philnik/crane/03.crane_roller.org

#+TITLE:     crane roller
#+SETUPFILE: ./setup/setup_theme.org

* Ρουλεμαν ολίσθησης

** Δυναμη ανύψωσης

Η μεγιστη δύναμη ανύψωσης είναι:
#+tblname: Forces_at_c
| Είδος δύναμης                |  Τιμή(Ν) |
|------------------------------+----------|
| Μέγιστη δυνατότητα ανύψωσης: |    20000 |
| Συρματόσχοινο:               |      860 |
| Γαντζος                      |       70 |
|------------------------------+----------|
| Αθροισμα:                    |    20930 |
|                              | 20.930kN |
#+TBLFM: @5$2=vsum(@2..@4)

Η δύναμη θα ισομοιραστεί σε 8 ρόδες κύλισης πάνω στη δοκό.

Η δύναμη σε κάθε ρόδα είναι:
|                                   |          |   |
|-----------------------------------+----------+---|
| Δύναμη ανύψωσης :                 |    20930 | Ν |
| Δύναμη μηχανισμού ανύψωσης        |     1000 | Ν |
|-----------------------------------+----------+---|
| Άθροισμα:                         |    21930 | Ν |
| Αριθμός ροδών κύλισης             |        8 |   |
|-----------------------------------+----------+---|
| Δύναμη σε κάθε ρόδα               |  2741.25 | N |
| Εδρανα κύλισης ανά ρόδα:          |        2 |   |
| Κάθετη δύναμη στο έδρανο κύλισης* | 1370.625 | N |
#+TBLFM: @4$2=@2+@3::@6$2=@4/@5::@8$2=@6/@7

*Η δύναμη σε κάθε έδρανο κύλισης εξαρτάται και από τον τρόπο στήριξης και μπορεί να είναι διαφορετική σε κάθε έδρανο.

https://www.skf.com/in/products/rolling-bearings/ball-bearings/deep-groove-ball-bearings/productid-6000

Επιλέγονται ρουλεμαν SKF 10-6000

|                           |              |
|---------------------------+--------------|
| Bore diameter             | 10 mm        |
| Outside diameter          | 26 mm        |
| Width                     | 8 m          |
| Basic dynamic load rating | 4.75 kN      |
| Basic static load rating  | 1.96 kN      |
| Limiting speed            | 40 000 r/min |
| Reference speed           | 67 000 r/min |
| SKF performance class     | SKF Explorer |

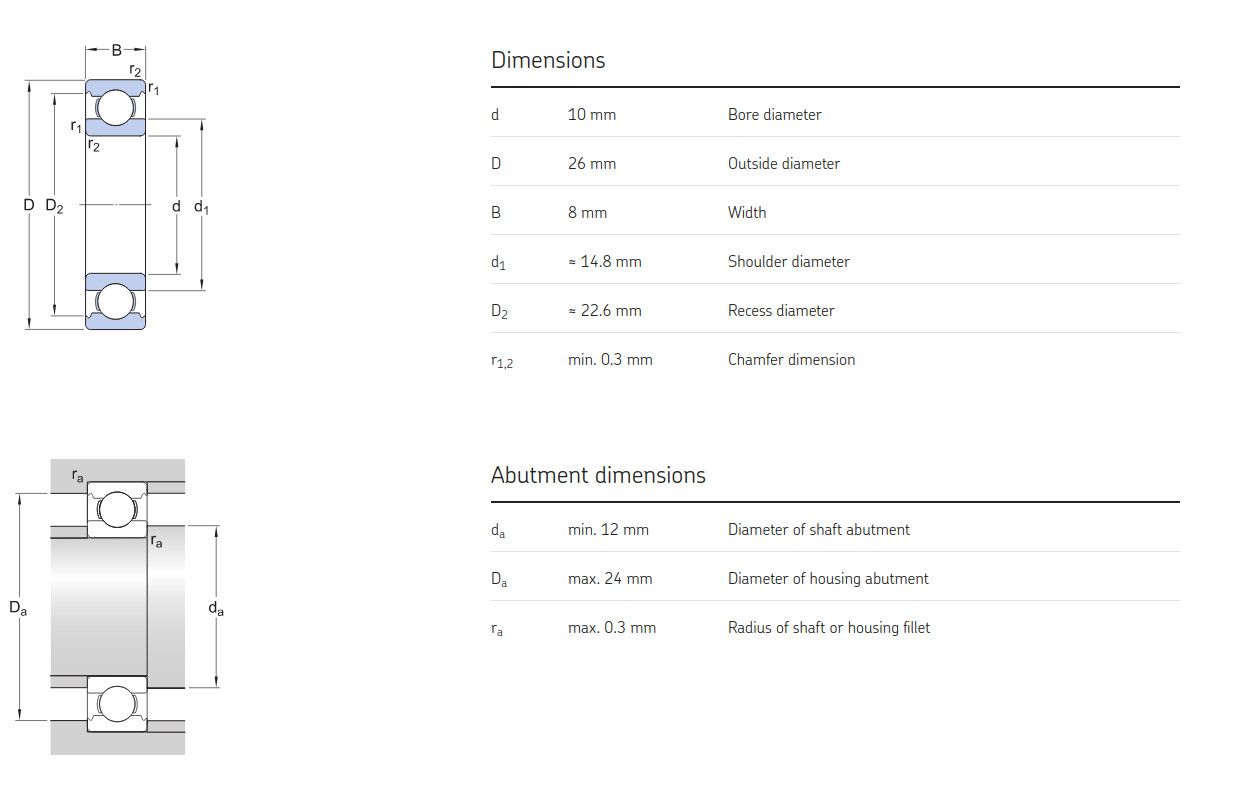
[picture p5: images/roller_bearing0.jpg]


** Ροδες κύλισης

Επιλέγονται 8 ρόδες με εξωτερική διάμετρο 34mm και πλάτος 30mm

| Εξωτερική διάμετρος | Παχος [t] | Εσωτερική διάμετρος |
| mm                  | mm        |                     |
|---------------------+-----------+---------------------|
| 34.0                | 3.2       |                27.6 |
#+TBLFM: $3=$1-2*$2

https://www.karl-georg.de/images/sortiment_laufraeder/pdf/en/crane_wheels-general_information.pdf

Τα ρουλεμαν λιπαινονται με γρασο, λογω του χαμηλού αριθμού στροφών.

** Αξονας ρουλεμαν

Ο αξονας επιλέγεται με βάση τα ρουλεμαν 10mm

** Σχέδια στηριξης

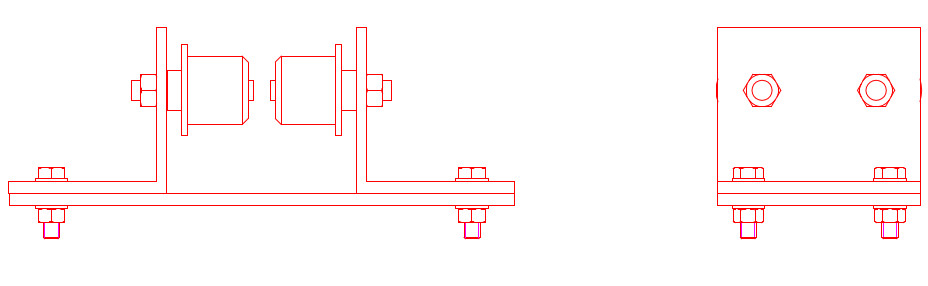
[picture p6: images/roller0.jpg]


** Σχέδια ρουλεμαν

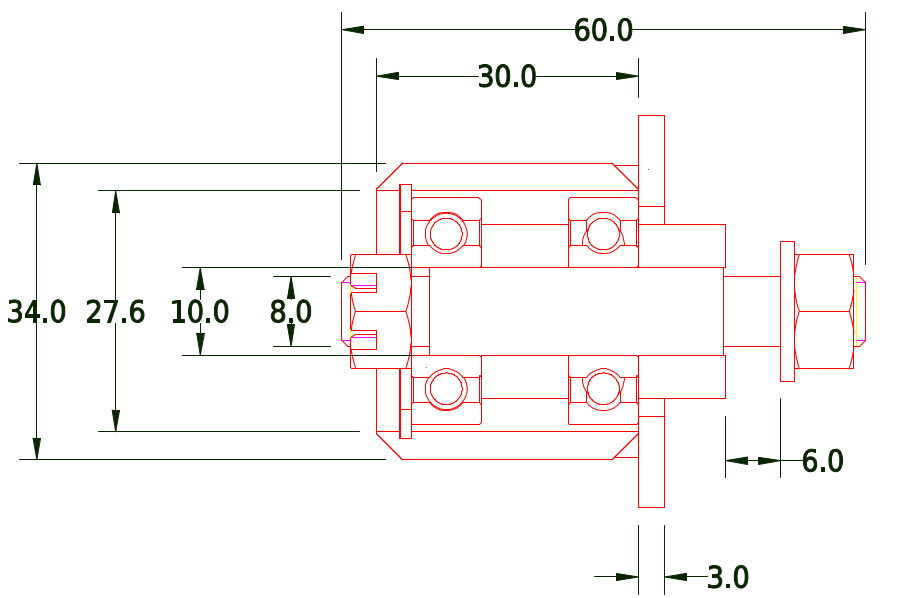
[picture p7: images/roller_detail.jpg]
