philnik/crane/02.column_ac.org

#+TITLE:     column-ac
#+SETUPFILE: ./setup/setup_theme.org

* Υπολογισμός ράβδου AC

** Δοκοί που επιλέγονται

https://eurocodeapplied.com/design/en1993/ipe-hea-heb-hem-design-properties

** Με δοκό ΗΕΑ
#+tblname: hea_beam
| Profile                                     | *HEA100* | HEA120 |
|---------------------------------------------+----------+--------|
| Depth  h  [mm]                              |       96 |    114 |
| Width  b  [mm]                              |      100 |    120 |
| Web thickness  tw  [mm]                     |        5 |      5 |
| Flange thickness  tf  [mm]                  |        8 |      8 |
| Weight  m  [kg/m]                           |     16.7 |   19.9 |
| Perimeter  P  [m]                           |    0.561 |  0.677 |
| Area  A  [mm2]                              |     2124 |   2534 |
| *Second moment of area  Iy*  [×106 mm^4]    |  *3.492* |  6.062 |
| Elastic section modulus  Wel,y  [×103 mm^3] |    72.76 |  106.3 |
| Plastic section modulus  Wpl,y  [×103 mm^3] |    83.01 |  119.5 |

** Με δοκο IPE
#+tblname: ipe_beam
| Profile                                    |  IPE80 | IPE100 | IPE120 | IPE140 | IPE160 |
|--------------------------------------------+--------+--------+--------+--------+--------|
| Depth  h  [mm]                             |     80 |    100 |    120 |    140 |    160 |
| Width  b  [mm]                             |     46 |     55 |     64 |     73 |     82 |
| Web thickness  tw  [mm]                    |    3.8 |    4.1 |    4.4 |    4.7 |      5 |
| Flange thickness  tf  [mm]                 |    5.2 |    5.7 |    6.3 |    6.9 |    7.4 |
| Root radius  r  [mm]                       |      5 |      7 |      7 |      7 |      9 |
| Weight  m  [kg/m]                          |      6 |    8.1 |   10.4 |   12.9 |   15.8 |
| Perimeter  P  [m]                          |  0.328 |    0.4 |  0.475 |  0.551 |  0.623 |
| Area  A  [mm2]                             |    764 |   1032 |   1321 |   1643 |   2009 |
| Shear area z-z  Av,z  [mm2]  (for η=1.2)   |    358 |    508 |    631 |    764 |    966 |
| Shear area y-y  Av,y  [mm2]                |    478 |    627 |    806 |   1007 |   1214 |
| Second moment of area  Iy  [×106 mm4]      | 0.8014 |   1.71 |  3.178 |  5.412 |  8.693 |
| Radius of gyration  iy  [mm]               |   32.4 |   40.7 |     49 |   57.4 |   65.8 |
| Elastic section modulus  Wel,y  [×103 mm3] |  20.03 |   34.2 |  52.96 |  77.32 |  108.7 |
| Plastic section modulus  Wpl,y  [×103 mm3] |  23.22 |  39.41 |  60.73 |  88.34 |  123.9 |

** Υπολογισμός ραβδου (AC)

Η δοκός καταπονείται (AC) σε θλίψη.

Οι εξισώσεις της αξονικής φόρτισης είναι:

$$\sigma = \frac{P}{A}$$

$$\epsilon = \frac{\sigma}{E}$$

$$\delta = \frac{P \times l}{A \times E}$$

#+tblname: area_bc
|   |                        |         |              |      |                           |
|---+------------------------+---------+--------------+------+---------------------------|
|   | Μήκος ράβδου           |         |         3000 | mm   |                           |
|   | P                      | $C_x$   |           46 | kΝ   | εφελκυσμός στη ραβδο (ΒC) |
| ^ |                        |         |            p |      |                           |
|   | Τάση διαρροής (0.2%) : | σ       |          370 | MPa  |                           |
| ^ |                        |         |            s |      |                           |
|---+------------------------+---------+--------------+------+---------------------------|
|   | Επιφάνεια δοκού        | $Α=P/σ$ | 1.2432432e-4 | m^2  |                           |
|   |                        |         |          1.2 | cm^2 |                           |
|---+------------------------+---------+--------------+------+---------------------------|
| ^ |                        |         |            A |      |                           |
|   | ενταση:                | $ε=σ/Ε$ |      1.85e-3 |      |                           |
|   | Μετατόπιση:            |         |         5.55 | mm   |                           |
#+TBLFM: @7$4=$p*1e3 / ($s*1e6)::@10$4=$s*10^6/(200*10^9)::@11$4=($p*@2)/(@7*200*10^6);%.2f

Επομένως στο όριο της δύναμης και τάση διαρροής, η ράβδος πρέπει να έχει επιφάνεια: $Α:1.24\times10^{(-4)}m^2$

** Υπολογισμός σε λυγισμό                                          :noexport:

Η ράβδος καταπονείται σε θλίψη, και εξετάζεται και ως προς την αντοχή της σε λυγισμό.

$$P_1 = K1 \frac{π^2*Ε_1*Ι_1}{l^2}$$

Από τον πίνακα 15.1 περίπτωση 1c



|   |     |             |   |    |
|---+-----+-------------+---+----|
|   | K_1 | 1.0         |   |    |
| ^ |     | k1          |   |    |
|   | E1  | 200*10^9    |   | Pa |
| ^ |     | E1          |   |    |
|   | I1  | 0.669*10^-8 |   | m4 |
| ^ |     | I1          |   |    |
|   | l   | 3           |   | m  |
| ^ |     | L           |   |    |
|---+-----+-------------+---+----|
|   |     | 1466        |   | N  |
#+TBLFM: @10$3=$k1*3.14*3.14*$E1*$I1/($L*$L);%.0f

** Απαιτούμενη αδράνεια για λυγισμό                                :noexport:



|   |                      |              |           |    |
|---+----------------------+--------------+-----------+----|
|   | K_1                  |          0.5 |           |    |
| ^ |                      |           K1 |           |    |
|   | E1                   |     200*10^9 |           | Pa |
| ^ |                      |           E1 |           |    |
|   | P                    |        46000 |           | N  |
| ^ |                      |            P |           |    |
|   | l                    |            3 |           | m  |
| ^ |                      |            L |           |    |
|---+----------------------+--------------+-----------+----|
|   | (P*l^2)/(pi^2*E1*K1) | 4.1989533e-7 | m^4       | I  |
|   |                      |    41.989533 | cm^4      |    |
|   |                      |   0.41989533 | 10^6 mm^4 |    |
#+TBLFM: @10$3=($P*$L^2)/(3.14^2*$E1*$K1)::@11$3=@-1*10^8::@12$3=@10*1e12*1e-6

Ο συντελεστής Κ1 εξαρτάται από το είδος της φόρτισης και θεωρείται  δυσμενέστερη περίπτωση $Κ1=0.507$ για ενδιάμεσο φορτίο. 

Καλπύπτουν μια από τις ακόλουθες:
- IPN80
- HEA100

** Υπολογισμός σε κάμψη

Η οριζόντια ράβδος υπολογιζεται και ως προς την αντοχή της σε κάμψη, λόγω της οριζόντιας κίνησης του κάθετου φορτίου σε ενδιάμεσες θέσεις.

Η τάση είναι:
$$\sigma = \frac{M \times c}{I}$$

Ο συντελεστής αξονικού φορτίου σε θλίψη είναι:

$$k = {\frac{P} { E \times I}}^{0.5}$$



Tο κρίσιμο σημείο αντοχής είναι κάμψη οταν η θέση του φορτίου ανύψωσης είναι στη μέση των δύο στηρίξεων (Α), (C).

Επίσης η ροπή κάμψης μειώνεται με το μήκος της ανοίγματος (AC)

Λυνουμε το σύστημα των εξισώσεων

Με δοκιμές για τις δοκούς είναι:

#+tblname: IPE_beams_calculations
|        | I [x10^6 mm^4} | Οριζόντια απόσταση l [mm] | σ [ΜPa] |   |
|--------+----------------+---------------------------+---------+---|
| IPE80  |         0.8014 |                      3000 |    3859 |   |
|        |                |                      1500 |    1589 |   |
|--------+----------------+---------------------------+---------+---|
| IPE100 |           1.71 |                      3000 |    1839 |   |
|        |                |                      1500 |     732 |   |
|--------+----------------+---------------------------+---------+---|
| IPE120 |          3.178 |                      3000 |     794 |   |
|        |                |                      1500 |     389 |   |
|--------+----------------+---------------------------+---------+---|
| IPE140 |          5.412 |                      3000 |     466 |   |
|        |                |                      2600 |     400 |   |
|        |                |                      2500 |     384 |   |
|        |                |                      2400 |     368 |   |
|        |                |                      2000 |     305 |   |
|        |                |                      1500 |     231 |   |
|        |                |                      1000 |     150 |   |
|--------+----------------+---------------------------+---------+---|

Το όριο διαρροής του σιδήρου είναι $$sigma=370MPa$$ και επιλέγεται δοκός IPE140.

To σημείο (C) μετατοπίζεται αριστερά.

*** maxima                                                         :noexport:

#+name: k_calculate
#+begin_src maxima :results output html :export result :results raw :drawer EXPORT_HTML
fpprintprec:3$

eq1: M = (W/(2*k)) * tan(k*l/2)$
disp(tex(eq1));

eq2: k=(P/(E1*I1))^0.5$
disp(tex(eq2));

eq3: M = (W/(2*k)) * tan(k*l/2);
disp(tex(eq3));

eq4: sigma = M * C / I$
print(tex(eq4));

P:46000$
E1:200*10^9$
W:27140;
M_max:M;
c:80e-3;
I:I1;
#+end_src
#+RESULTS: k_calculate
3000 2.1E+12 

      0.08 M
$$σ= ------ N/m^2$$ 
        I1

O αριθμητικός υπολογισμός δίνεται στο συνημμένο αρχείο:
[[./maxima/column_ac.mac]]

** Υπολογισμός θέσης σημείου C



Με μετακίνηση του σημείου (C) δημιουργείται ένας προβολος όταν ο γερανός μετακινείται στο πιο δεξιο σημείο.

Η ροπή είναι:

$$M=-W\times l$$

Ο πινακας υπολογισμού γίνεται:
#+tblname: IPE_beams_calculations2
|        | I [x10^6 mm^4} | Οριζόντια προβολή l2=3000-l  [mm] | σ [ΜPa] |   |
|--------+----------------+-----------------------------------+---------+---|
| IPE140 |          5.412 |                              2000 |    1400 |   |
|        |                |                              1000 |     702 |   |
|        |                |                               500 |     351 |   |
|        |                |                               400 |     280 |   |

*** maxima                                                         :noexport:

#+name: k_calculate_out
#+begin_src maxima :results output html :export result :results raw :drawer EXPORT_HTML
fpprintprec:3$
l2:1.5;
W:27140;
M:W*l2;
C:0.140;
I:5.412*10^6*10^(-12);
sigma : M * C / I$
print("l=",l2,"sigma=",sigma);
#+end_src

Επομένως επιλέγουμε οριζόντια προβολή εξωτερικά του (C) 500mm.

#+name: stability_ac
#+begin_src maxima :results output html :export result :results raw :drawer EXPORT_HTML
fpprintprec:3$

eq1: P=K1*%pi^2*E1*I1/l^2$
eq2: solve(eq1,I1);
print(tex(eq2));
print(eq2);
#+end_src

#+RESULTS: stability_ac
false 
            2
         P l
[I1 = ----------] 
         2
      %pi  E1 K1

** maxima                                                          :noexport:

programmode:false;

#+name: tension_maxima
#+begin_src maxima :results output html :export result :results raw :drawer EXPORT_HTML
fpprintprec:3$

eq1: sigma = P/A$
print(tex(eq1));

eq2: e = sigma / E$
print(tex(eq2));

eq3: delta = (P*l) / (A*E)$
print(tex(eq3))$

eq10a:solve(eq1,A)$
print(tex(eq10a));

P:54.28$
print("$$P:",P,"kN$$");

sigma:370$
print("$$σ:",370,"MPa$$");

A:(P*10^3) / (sigma*10^6) $
print("$$A:",A,"m^2$$");

E:200*10^9$
epsilon:sigma/E$
epsilon:(sigma*10^6) / E,numer$
print("$$ε:",epsilon,"$$");

l:3150$
delta: P*l / (A*E);
print("$$delta:",delta,"m$$");
#+end_src

false 
$$P: 54.2 kN$$ 
$$σ: 370 MPa$$ 
$$A: 1.46E-4 m^2$$ 
$$ε: 0.00185 $$ 
$$delta: 0.00582 m$$
