philnik/crane/04.winch.org

#+TITLE:     crane roller
#+SETUPFILE: ./setup/setup_theme.org

* Σύστημα ανύψωσης

** Δεδομένα                                                        :noexport:

Δεδομένα συστήματος:
    • L=3000 mm, R2=2800mm, R1=960mm, H=1950 mm
    • Διάμετρος τυμπάνου περιέλιξης συρματόσχοινου: 350 mm
    • Μέγιστο βάρος συρματόσχοινου: 86 Krg
    • Βάτος γάντζου ανύψωσης: 7 Krg 
    • Μέγιστη ταχύτητα ανύψωσης: 12 m/min
    • Συνολικό βάρος γερανού: 621 Kgr

Ζητούμενα:

** Υπολογισμός                                                     :noexport:

Μέρος 1 (40 Βαθμοί)
Υπολογίστε και επιλέξτε:
    • Το είδος του μειωτήρα με στόχο την επίτευξη της μέγιστης ταχύτητας ανύψωσης 
    • Τον ολικό βαθμό μείωσης
    • Τον κατάλληλο ηλεκτροκινητήρα με στόχο την ανύψωση και συγκράτηση του ανυψούμενου βάρους
    • Τις διαστάσεις του συνόλου του μειωτήρα (πχ, των χρησιμοποιούμενων γραναζιών, σφηνών, αξόνων, αποστάσεων, ανοχών, ρουλεμάν κ.α.) ώστε να εμπίπτει στις προδιαγραφές μαζί με τους απαραίτητους  υπολογιστικούς ελέγχους.
    • Δημιουργία του 3D μοντέλου του μειωτήρα μαζί με τα κατάλληλα κατασκευαστικά σχέδια τόσο των επιμέρους εξαρτημάτων όσο και του συναρμολογήματος (συμπεριλαμβάνετε η βάση και το καπάκι).

** Δύναμη ανύψωσης

Η μεγιστη δύναμη ανύψωσης είναι:
#+tblname: Forces_at_c
| Είδος δύναμης                |  Τιμή(Ν) |
|------------------------------+----------|
| Μέγιστη δυνατότητα ανύψωσης: |    20000 |
| Συρματόσχοινο:               |      860 |
| Γαντζος                      |       70 |
|------------------------------+----------|
| Αθροισμα δύναμης F:          |    20930 |
|                              | 20,93kN  |

** Υπολογισμός συστήματος ανύψωσης

** Ισχύς ανύψωσης
H απαιτούμενη ισχύς είναι:

$$W_{lift} = F \times u$$,

όπου F η δύναμη ανύψωσης $F = 21kN$
u η ταχύτητα ανύψωσης $u = 12\dfrac{m}{min}$

|                       |       |         |
|-----------------------+-------+---------|
| Δυναμη ανύψωσης [F]   |    21 | kN      |
| Ταχύτητα ανύψωσης [u] |    12 | $\dfrac{m}{min}$ |
|-----------------------+-------+---------|
| W_{lift}              | 4200. | W       |
#+TBLFM: @4$2=@2*@3*1e3/60.0

** Ροπή στρέψης τυμπάνου περιελιξης

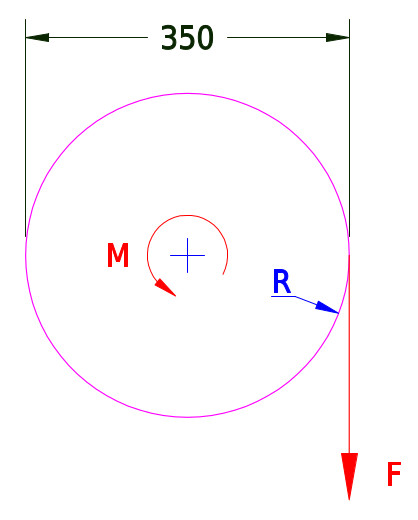
[picture p12: images/winch0.jpg]


Η ροπή στρέψης από την ανύψωση του φορτίου είναι:

$$Μ_{lift} = F \times R $$

|                     |       |    |
|---------------------+-------+----|
| Δυναμη ανύψωσης [F] |    21 | kN |
| Διάμετρος τυμπάνου  |   350 | mm |
|---------------------+-------+----|
| M_{lift}            | 3.675 | N*m |
#+TBLFM: @4$2=@2*@3*0.5*1e-3

** Στροφές τυμπάνου περιέλιξης

$$u_{lift} = \omega \times R $$

$$\omega = \frac{u_{lift}}{R} $$

|                        |     |                 |
|------------------------+-----+-----------------|
| Ταχύτητα ανύψωσης [u]  |  12 | $\frac{m}{min}$ |
| Διάμετρος τυμπάνου [D] | 350 | $mm$            |
|------------------------+-----+-----------------|
| $\omega$               |  69 | rpm             |
#+TBLFM: @4$2=60*(12/60)/(0.350/2);%.0f

** Επιλογή ανεμιστήρα

Επιλέγεται ηλεκτροκινητήρας:

|                     |     |     |
|---------------------+-----+-----|
| Ισχύς               |   4 | kW  |
| Στροφές λειτουργίας | 750 | rpm |

** Επιλογή συρματόσχοινο

Επιλέγεται συματόσχοινο με διάμετρο 6.4mm σύμφωνα με τον παρακάτω πίνακα:

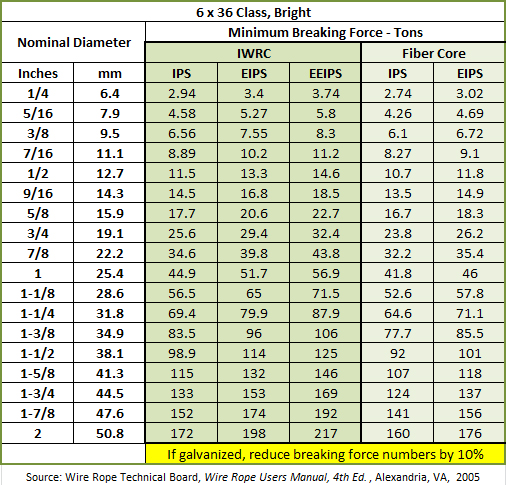
[picture p13: images/wire_rope.jpg]


Για μήκος περίπου 3m είναι:

|                                     |           |        |
|-------------------------------------+-----------+--------|
| Διάμετρος συρματόσχοινο             |       6.4 | mm     |
| Επιφάνεια                           |   32.1536 | $mm^2$ |
| Μήκος                               |      3000 | mm     |
| Όγκος                               |   96460.8 | mm^3   |
| Διάμετρος τυμπάνου                  |       350 | mm     |
#+TBLFM: @3$2=3.14*@-1*@-1/4.0::@5$2=@3*@4::@7$2=@5/@6*3.14::@9$2=1000*@7/@8

Η σχέση εξωτερικής διαμέτρου τυμπάνου και μήκους είναι:
|   | Rin | Rout |   L |
|---+-----+------+-----|
|   | 175 |  300 | 517 |
|   | 175 |  350 | 330 |

** maxima                                                          :noexport:
#+begin_src maxima
d:6.4E-3;
r:0.5*d;
area:d*d; /* area of wire rope square */
l:24;
v1: area * l;

V(Rin,Rout,L) := %pi*(Rout^2-Rin^2)*L;

#+end_src

** Διαστάσεις σωλήνα συρματοσχοινου

|  DN | NB(inch) |  ASME | SCH10 |      |
|-----+----------+-------+-------+------|
| 350 | 14"      | 355.6 |  6.35 | 7.92 |

** Αξονας στρέψης συρματόσχοινου

Η ροπή στρέψης είναι: $Τ:3675Nm$

|   |                 |          |       |   |      |
|---+-----------------+----------+-------+---+------|
| T |                 |     3675 |  3675 |   | Nm   |
| t |                 |      2.3 |   0.6 |   | mm   |
| D |                 |     21.7 |    20 |   | mm   |
| A | t*D*π           | 156.7174 | 37.68 |   | mm^2 |
|---+-----------------+----------+-------+---+------|
| τ | $\frac{T}{2tA}$ |      5.1 |  81.3 |   | MPa  |
|   |                 |          |       |   |      |
#+TBLFM: @3$4=2.3-1.7::@5$3..@5$4=@3*@4*3.14::@6$3..@6$4=(10^-6)10^(6)*@2/(2*@3*@5);%.1f

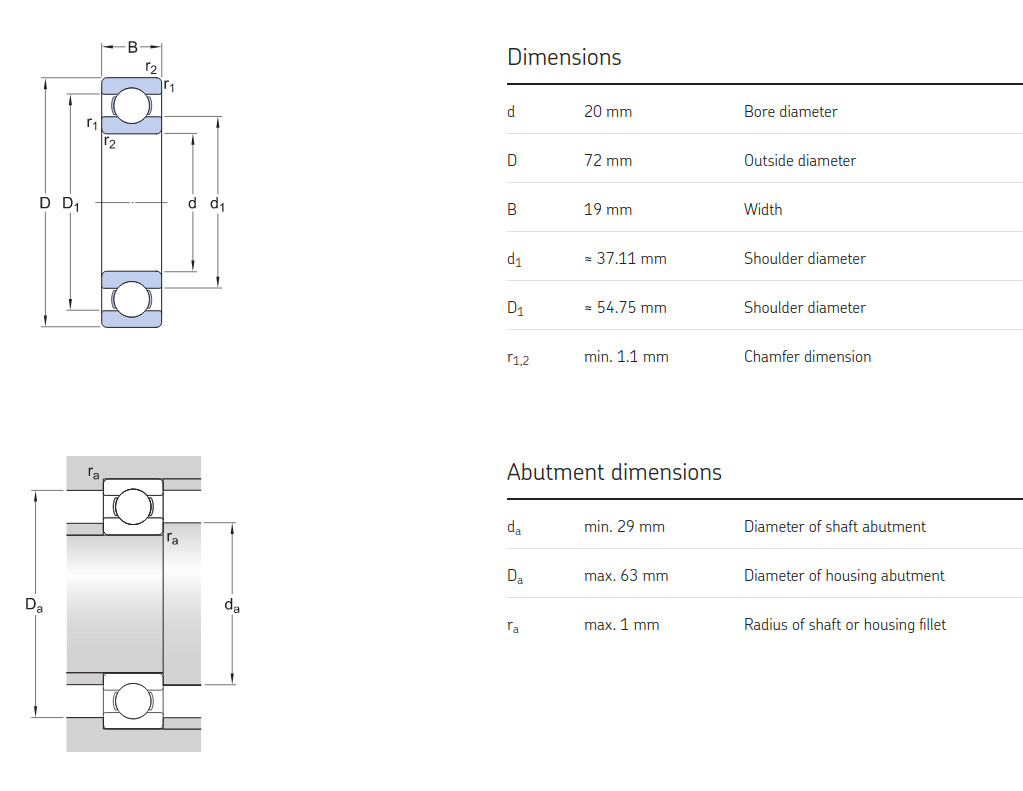
[picture p14: images/skf-20-6404.jpg]


** Ρουλεμαν

https://www.skf.com/in/products/rolling-bearings/ball-bearings/deep-groove-ball-bearings/productid-6404

Επιλέγεται τύπος ρουλεμάν: SKF-6404

Τεχνικά χαρακτηριστικά 1
|                           |         |
|---------------------------+---------|
| Basic dynamic load rating | 30.7 kN |
| Basic static load rating  | 15 kN   |
|---------------------------+---------|
| Bore diameter             | 20 mm   |
| Outside diameter          | 72 mm   |
| Width                     | 19 mm   |

Τεχνικά χαρακτηριστικά 1
| Basic dynamic load rating | C  | 30.7 kN      |
| Basic static load rating  | C0 | 15 kN        |
| Fatigue load limit        | Pu | 0.64 kN      |
| Reference speed           |    | 24 000 r/min |
| Limiting speed            |    | 15 000 r/min |
| Minimum load factor       | kr | 0.035        |
| Calculation factor        | f0 | 11           |

** Εσωτερική σωλήνα συρματοσχοινου

Πατάει στην εξωτερική του ρουλεμαν

|                 |      |
|-----------------+------|
| Diameter        | 76.3 |
| Wall thickness  |  2.8 |
| Inside diameter | 70.7 |
#+TBLFM: @3$2=@1-2*@2

** Επιλογή μειωτήρα                                                :noexport:
| Είδος                               |   Τιμή | Μονάδες |
|-------------------------------------+--------+---------|
| Στροφές ΗΚ [$i_1$]                  |    750 | rpm     |
| Στροφές τύμπάνου περιέλιξης [$i_2$] |     69 | rpm     |
|-------------------------------------+--------+---------|
| Σχέση μετάδοσης [$i]                | 10.870 |         |
| Επιλογή μειωτήρα με σχέση μετάδοσης |     12 |         |
#+TBLFM: @4$2=@2/@3;%.3f

Επιλογή module:
|                     |      |    |
|---------------------+------+----|
| module              |  2.5 |    |
| αρ.δοντιών          |  160 |    |
| εξωτερική διάμετρος | 400. | mm |
|                     |      |    |
#+TBLFM: @3$2=@1*@2

** κλπ                                                             :noexport:
| 1 |       175 |         0 |         0 |
| 2 |      87.5 |      87.5 |        1. |
| 3 | 58.333333 | 116.66667 | 2.0000001 |
| 4 |     43.75 |    131.25 |        3. |
|   |           |       175 |     175/0 |
#+TBLFM: $3=175-$-1::$4=$3/$2::@2$2=@1/$-1::@2$3=175-$2::@3$2=@1/$-1::@4$2=@1/$-1

| 1 |      87.5 |        0. |        0. |
| 2 |     43.75 |     43.75 |        1. |
| 3 | 29.166667 | 58.333333 | 2.0000000 |
| 4 |    21.875 |    65.625 |        3. |
|   |           |      87.5 |  87.5 / 0 |
#+TBLFM: $3=175*0.5-$-1::$4=$3/$2::@1$2=175/2.0::@2$2=@1/$-1::@2$3=175*0.5-$2::@3$2=@1/$-1::@4$2=@1/$-1

*** Σχεσεις μετάδοσης 

** Υπολογισμός πολυβάθμιου μειωτήρα                                :noexport:
H νεά σχέση μετάδοσης στο πολυβάθμιο μειωτήρα είναι:
| Α |  1 |
| Β |  3 |
| C |  2 |
| D |  2 |
|---+----|
|   | 12 |
#+TBLFM: @5$2=@1*@2*@3*@4

** Υπολογισμός σχέσης μετάδοσης

|   | Στροφές ΗΚ                             | $n_{motor}$                                             |  1400 | rpm   |
|---+----------------------------------------+---------------------------------------------------------+-------+-------|
|   | Μέση ταχύτητα ανύψωσης                 | $u_m$                                                   |    12 | m/min |
|   | Εσωτερική διάμετρος τυμπάνου           | $d_w = 2 \times r_w$                                    |   400 | mm    |
|   | Αριθμος συρματοσχοίνων                 | $k$                                                     |     2 |       |
|   | Περιστροφική ταχύτητα τυμπάνου         | $n_{winch} = k \times \dfrac{u_m}{r_w}$                 |   120 | rpm   |
|   | Σχέση μετάδοσης τυμπάνου               | $i_1 = \dfrac{1}{k} \times \dfrac{n_{motor}}{n_{winch}}$ | 11,66 |       |
|   | Από πίνακα σχέσης μετάδοσης επιλέγεται | $i_{total}$                                             |    12 |       |
|---+----------------------------------------+---------------------------------------------------------+-------+-------|
|   | Εσωτερική διάμετρος τυμπάνου           | $d_{in}$                                                |   350 | mm    |
|   | Εξωτερική διάμετρος τυμπάνου           | $d_{out}$                                               |   400 | rpm   |
|---+----------------------------------------+---------------------------------------------------------+-------+-------|
|   | Ταχύτητα max                           |                                                         |  8,75 |       |
|   |                                        |                                                         |       |       |
#+TBLFM: @9$4=$k*$um/($dm*0.5*1e-3);%.0f::@11$4=$nmotor/$nwinch

Η διάμετρος του τυμπάνου επηρρεάζει την ταχύτητα ανύψωσης, για σταθερές στροφές τυμπάνου.

** Πλανητικός μειωτήρας

https://en.wikipedia.org/wiki/Epicyclic_gearing

Τα στάδια του πλανητικού μειωτήρα είναι:
| Στάδια πλανητικού μειωτήρα |                    | Σχέση μετάδοσης |
|----------------------------+--------------------+-----------------|
| Στάδιο 1                   | $i_1$              |               4 |
| Στάδιο 2                   | $i_2$              |               3 |
|----------------------------+--------------------+-----------------|
|                            | $i = i_1 \times i_2$ |              12 |

** Διαστάσεις

|                     |       |   |     |    |
|---------------------+-------+---+-----+----|
| Διάμετρος δακτυλιου | $D_r$ |   | 270 | mm |
| Σχέση μετάδοσης     | $i$   |   |   3 |    |
| Διάμετρος κεντρικού | $d_r$ |   |  90 | mm |
#+TBLFM: @3$4=@1/@2
