philnik/crane/06.fem.org

#+TITLE:     winch
#+SETUPFILE: ./setup/setup_theme.org

* Ελεγχος με πεπερασμένα

** 22kN ελευθερο ακρο - Δυνάμεις



** 22kN ελευθερο ακρο - Παραμορφώσεις



*** 22kN στο μέσο - Δυνάμεις



*** Με τη διαγώνια ράβδο στήριξης 22kN στο μέσο - Παραμορφώσεις
