philnik/crane/07.drawings.org

#+TITLE:     winch
#+SETUPFILE: ./setup/setup_theme.org

* Σχέδια

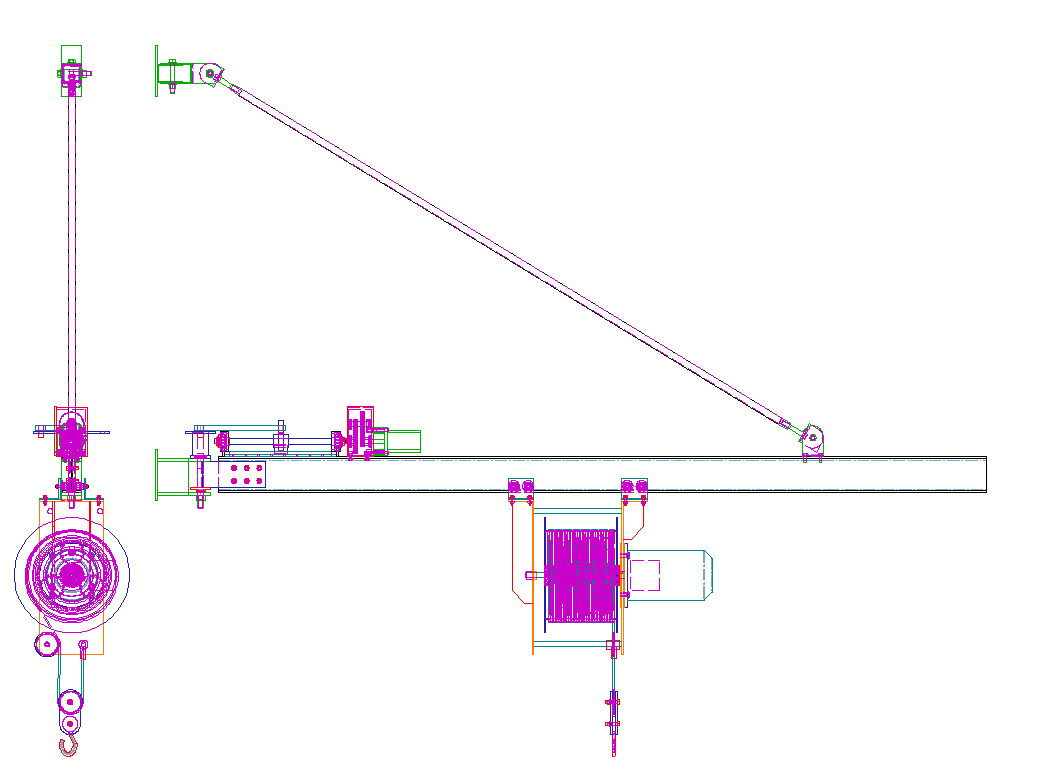
[picture p20: images/draw1.png]

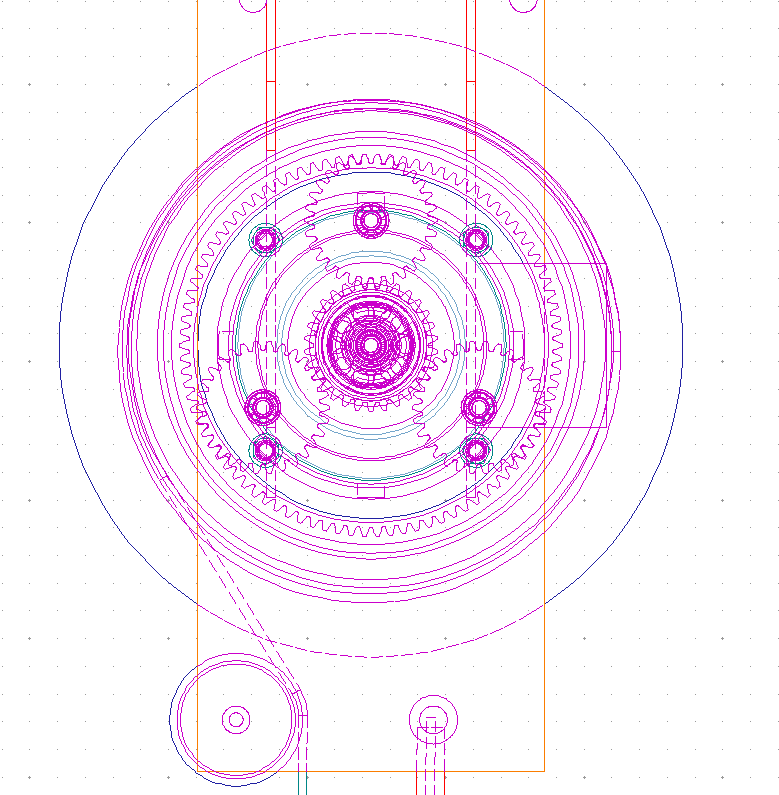
[picture p21: images/draw2.png]

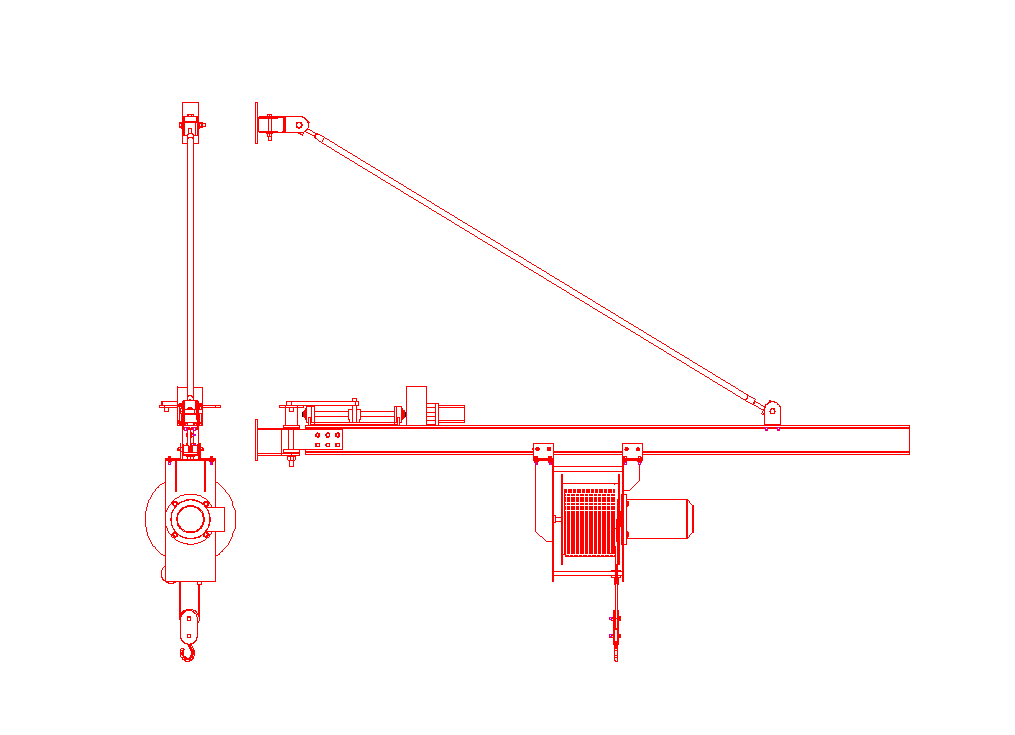
[picture p22: images/draw3.png]

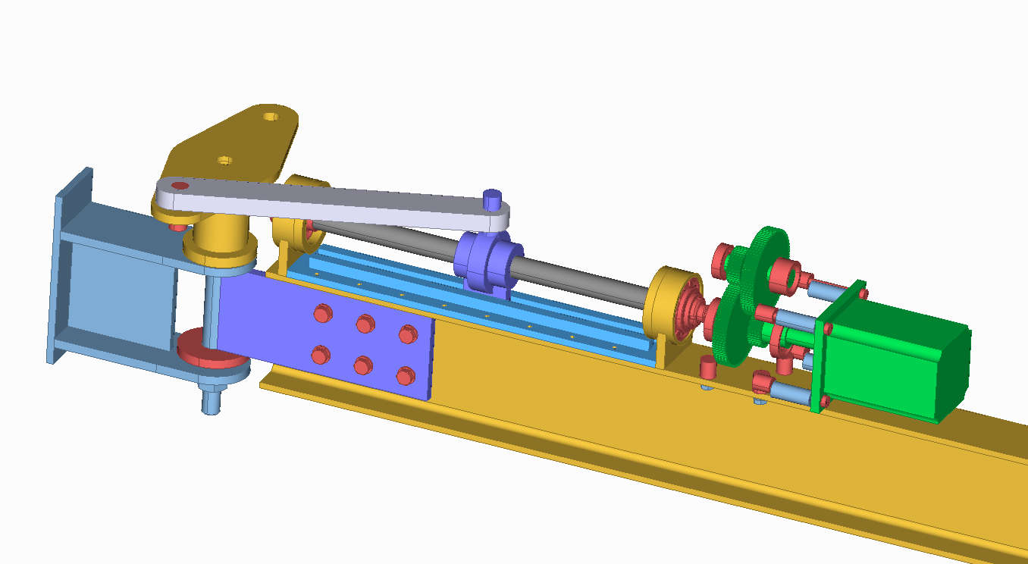
[picture p23: images/draw4.png]

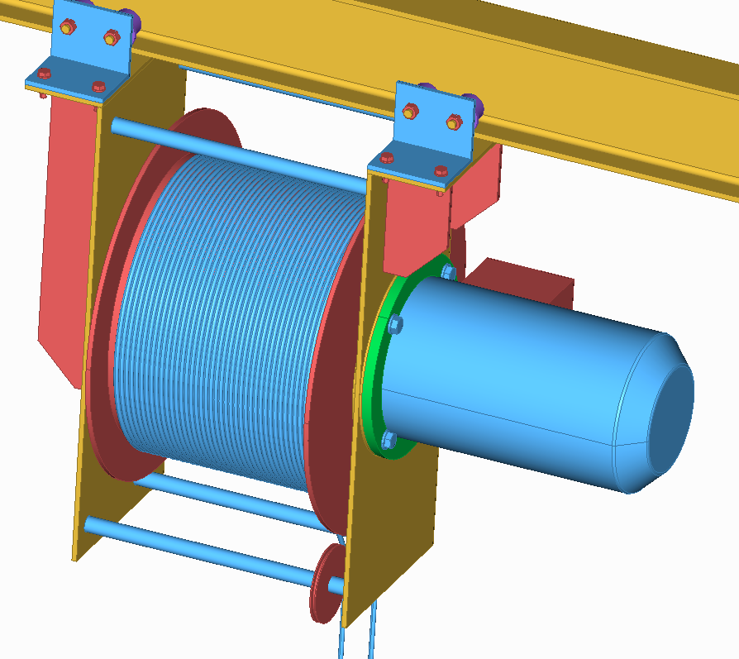
[picture p24: images/draw5.png]

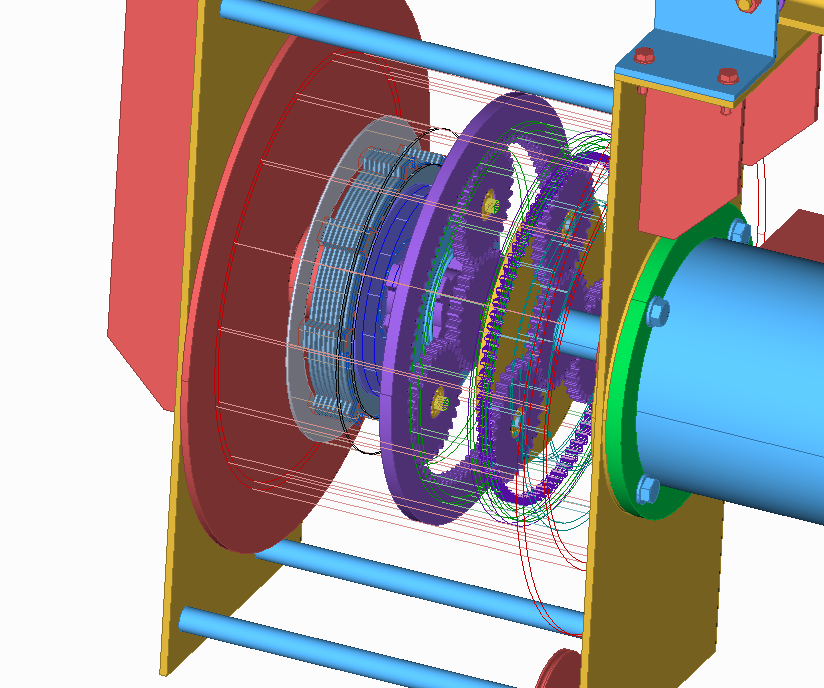
[picture p25: images/draw6.png]
