philnik/crane/pdf/crane0.pdf

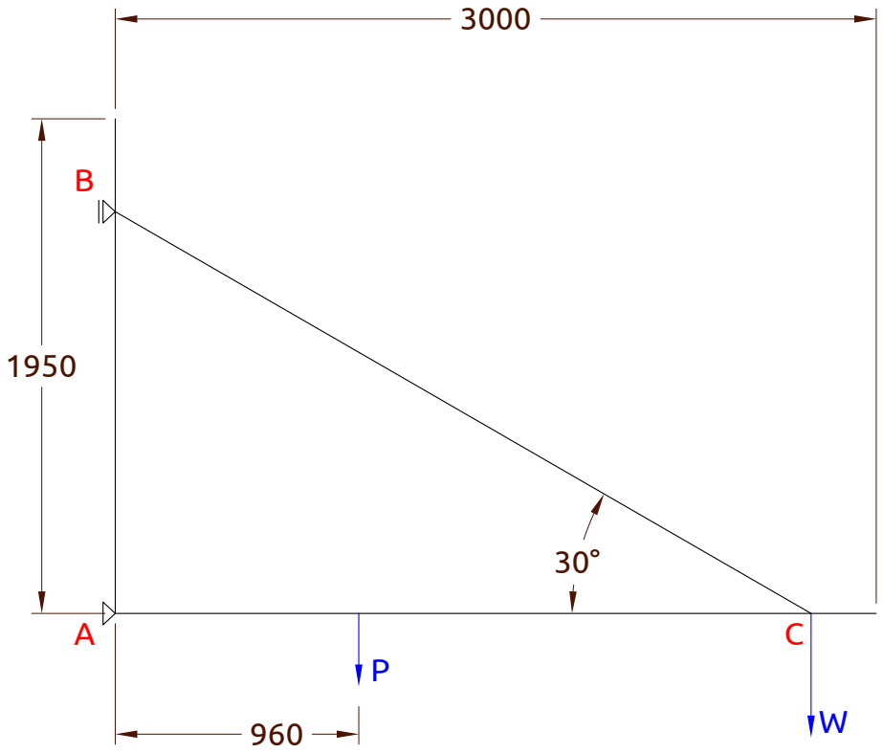
[picture p26: figure]

Cy

30°

Cx

C

Ay | C

Ax

A

A 30°

By

Bx

B

B 30°

Cy

30°

Cx

C

Ay | C

Ax

A

A 30°

By

Bx

B

B 30°
