philnik/crane/pdf/GEAR-REDUCER_Model-job_34.pdf

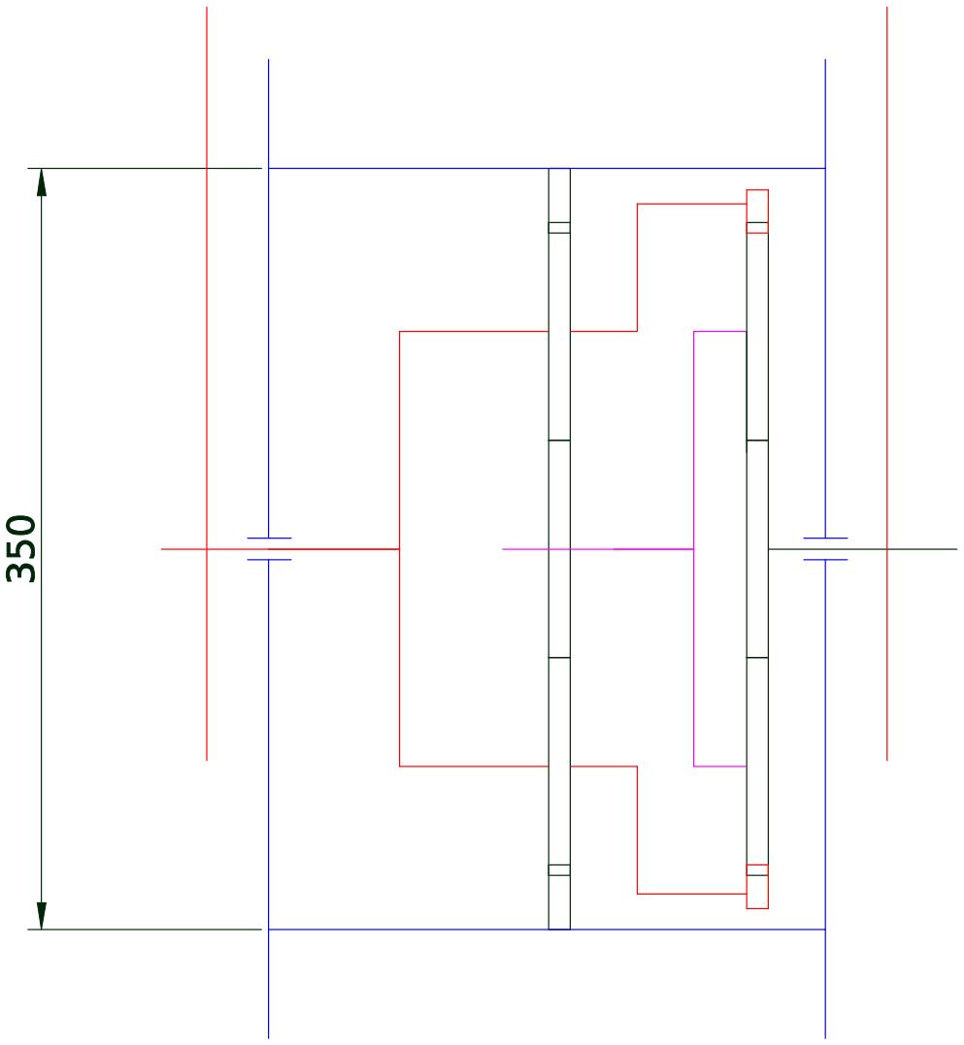
[picture p27: figure]
