philnik/crane/pdf/GEAR-REDUCER_Model-job_35.pdf

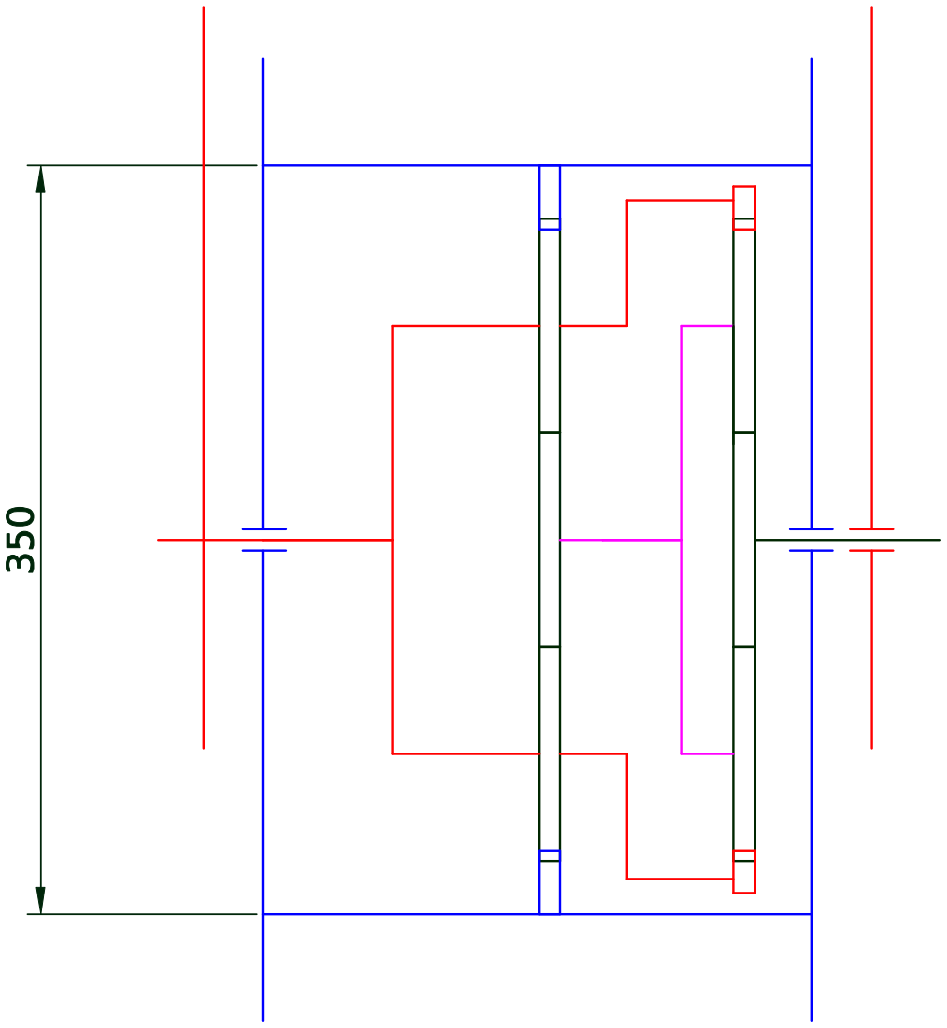
[picture p28: figure]
