philnik/crane/images/crane0.png

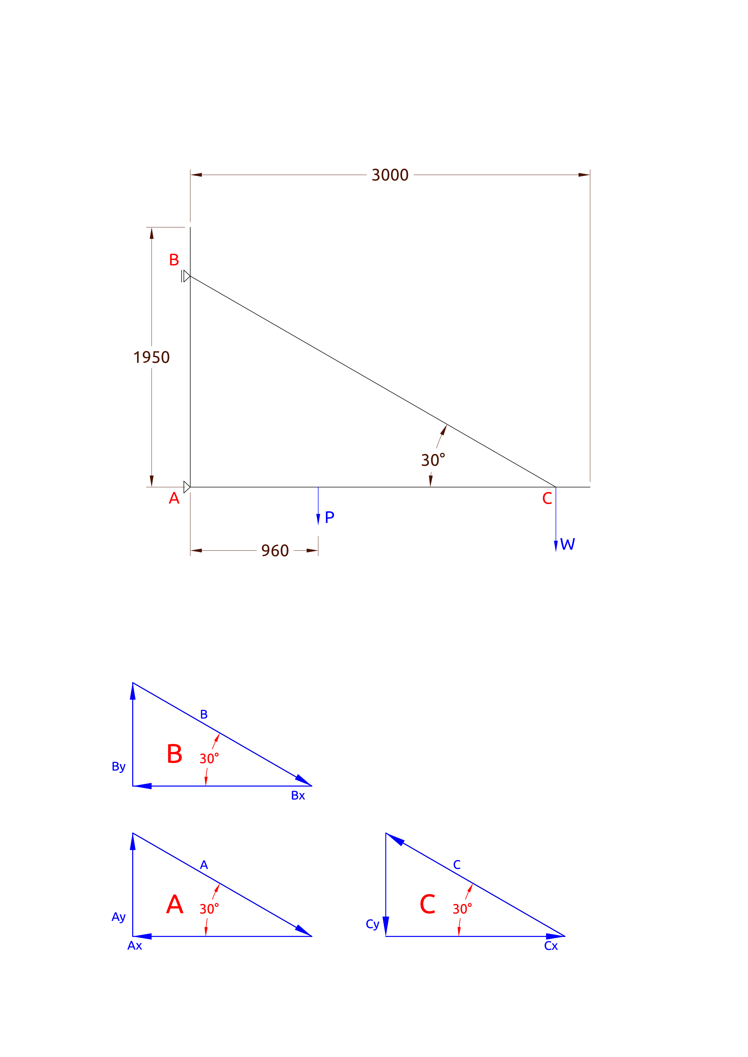
images/crane0.png
