philnik/crane/images/draw0.png

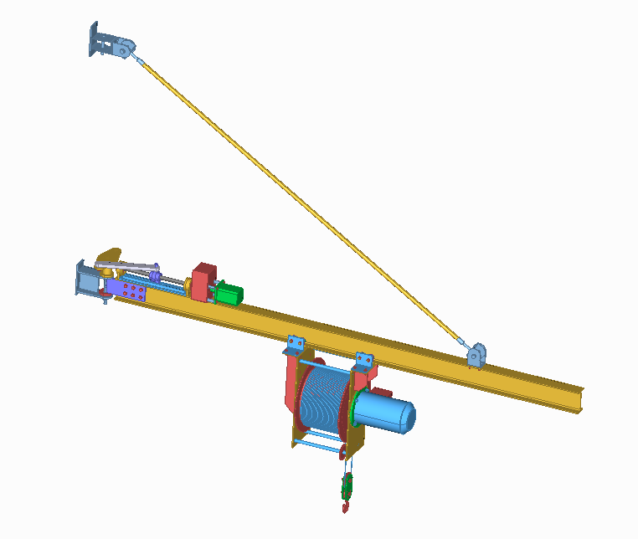
images/draw0.png
