philnik/crane/images/rotation_mechanism.png

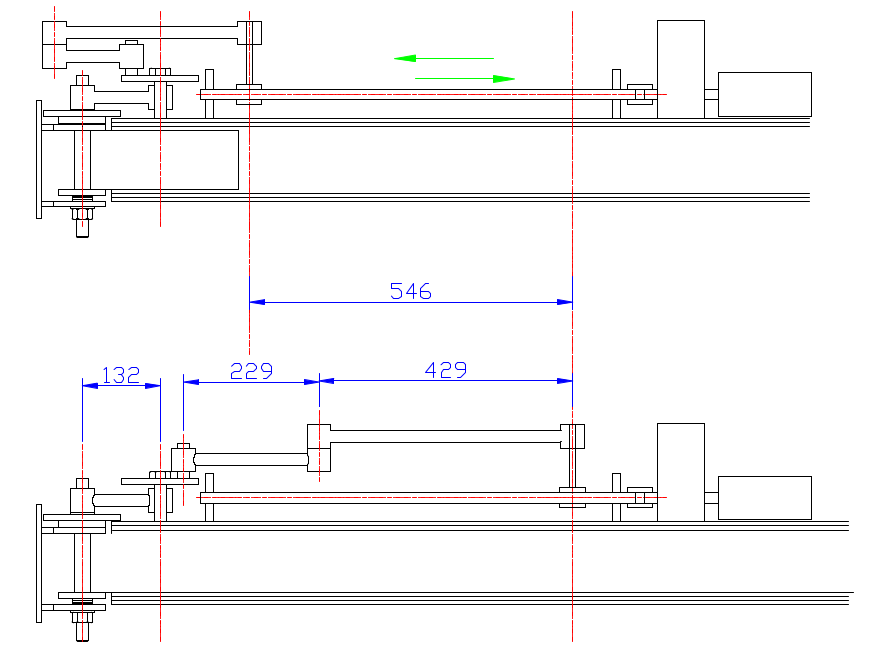
images/rotation_mechanism.png
