philnik/crane/images/x-o-roller.png

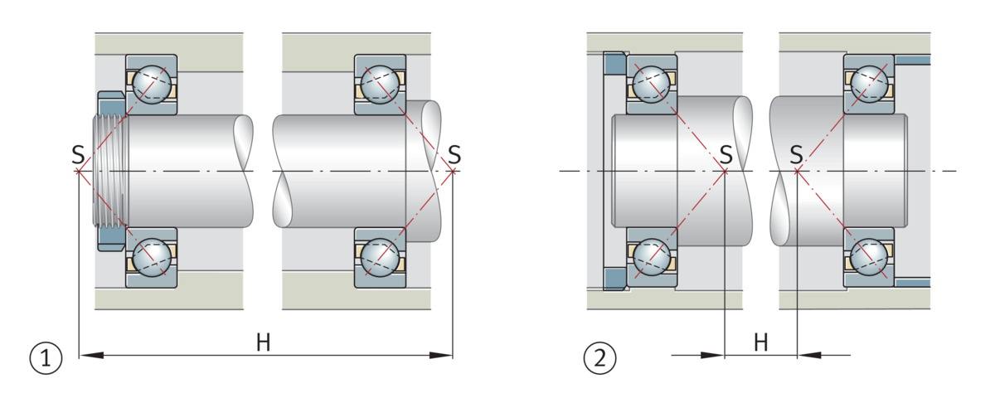
images/x-o-roller.png
