philnik/crane/cad3d/assembly.FCStd

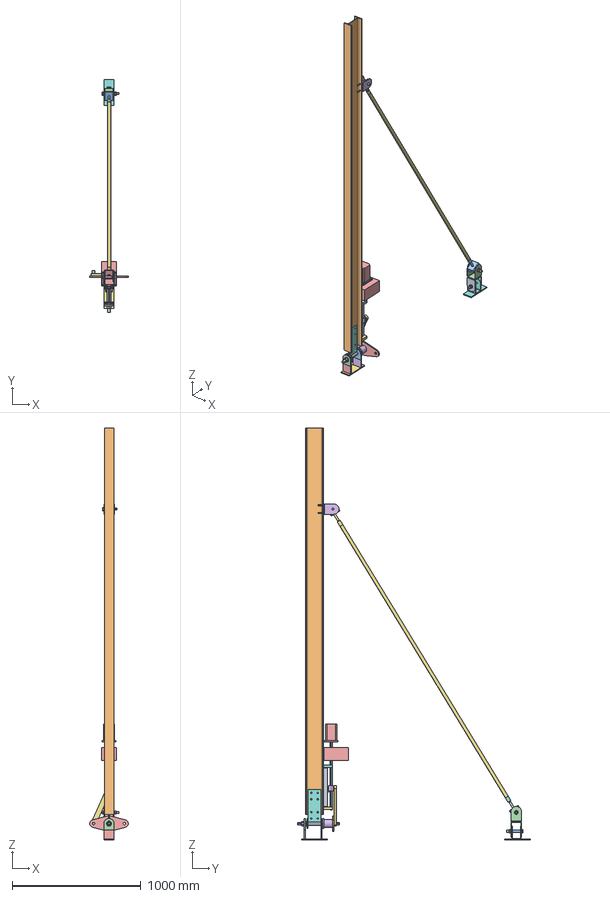
[picture p33: CAD file, 2024-03-31]
cad3d/assembly.FCStd
299.6 x 1807.5 x 3197.0 mm
