philnik/crane/cad2d/assembly.dxf

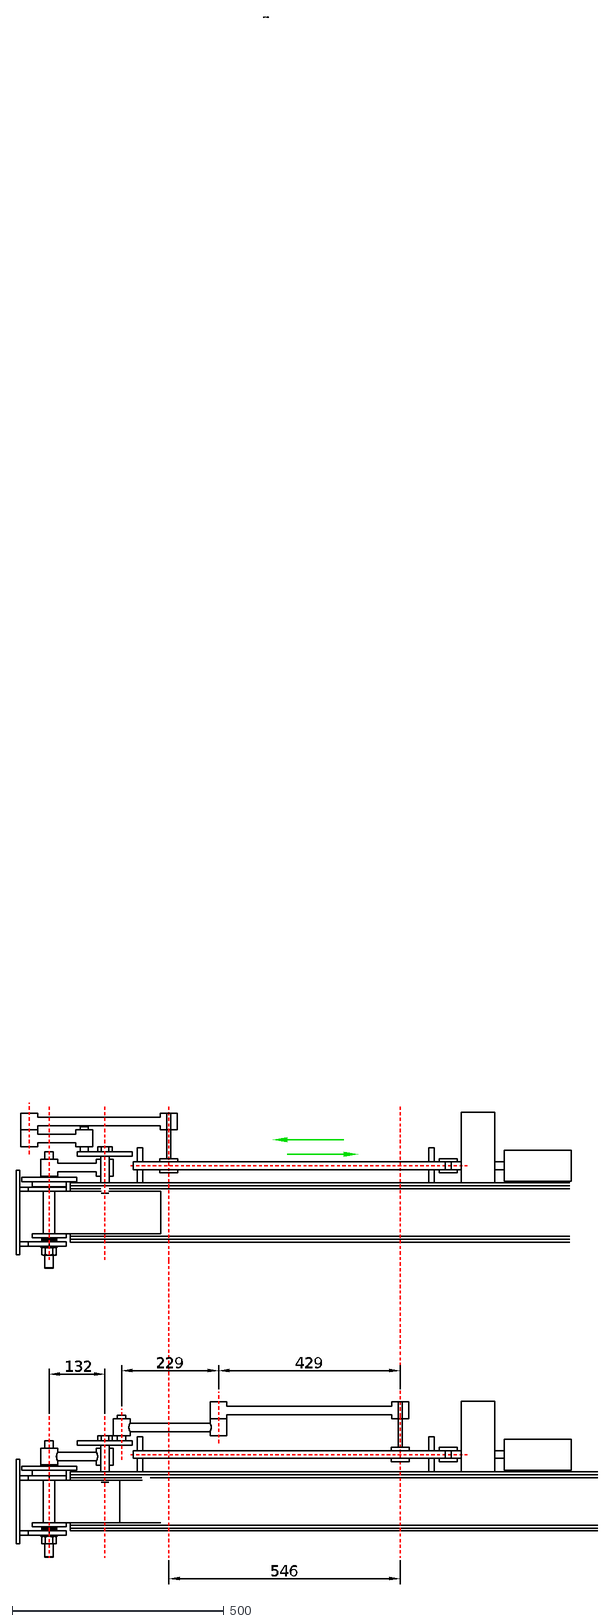
[picture p34: CAD file, 2024-03-31]
cad2d/assembly.dxf
0
546
429
229
132
