philnik/crane/cad3d/assembly1.stp

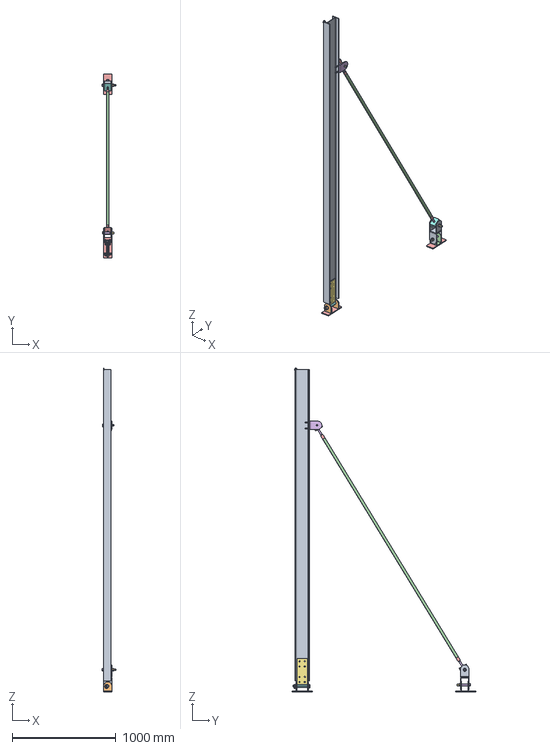
[picture p35: CAD file, 2024-03-31]
cad3d/assembly1.stp
130.0 x 1775.8 x 3120.0 mm
