philnik/crane/cad3d/nema42-stepper-motor.step

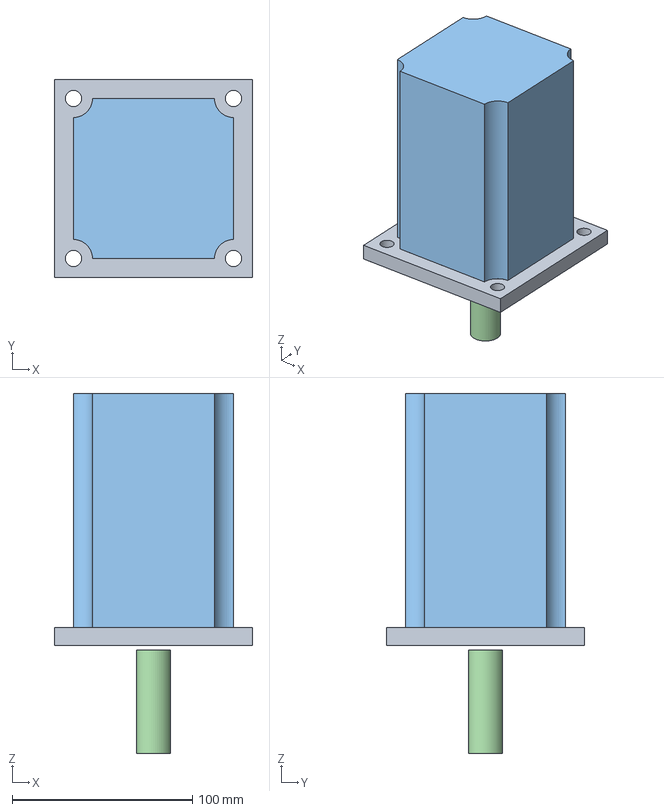
[picture p36: CAD file, 2024-03-31]
cad3d/nema42-stepper-motor.step
110.0 x 110.0 x 200.0 mm
