philnik/crane/cad2d/winch-wire.dxf

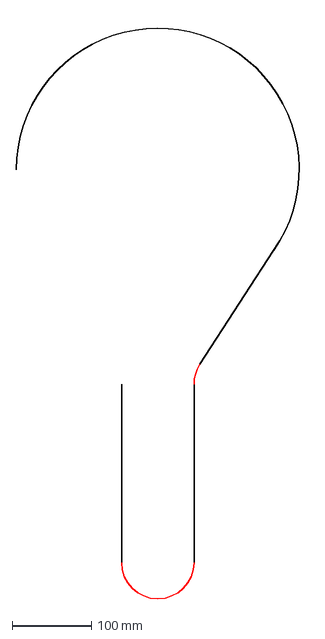
[picture p37: CAD file, 2024-03-31]
cad2d/winch-wire.dxf
367.9 x 733.6 mm
