philnik/crane/cad2d/ekkremes.dxf

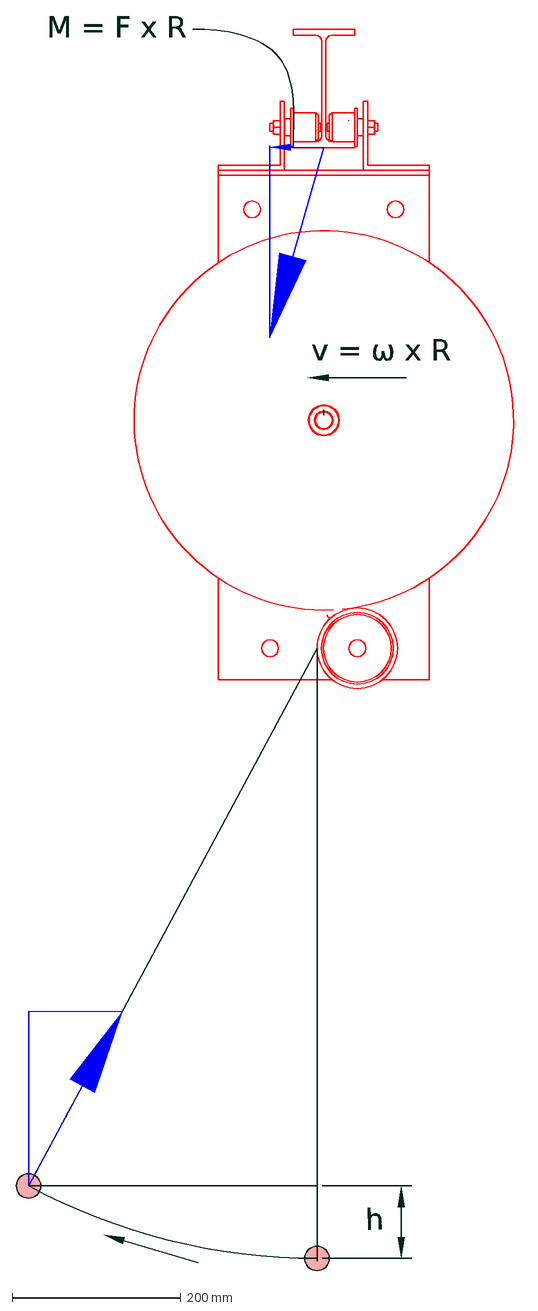
[picture p38: CAD file, 2024-03-31]
cad2d/ekkremes.dxf
v = ω x R
h
M = F x R
