philnik/crane/cad3d/rotary-piece-2.step

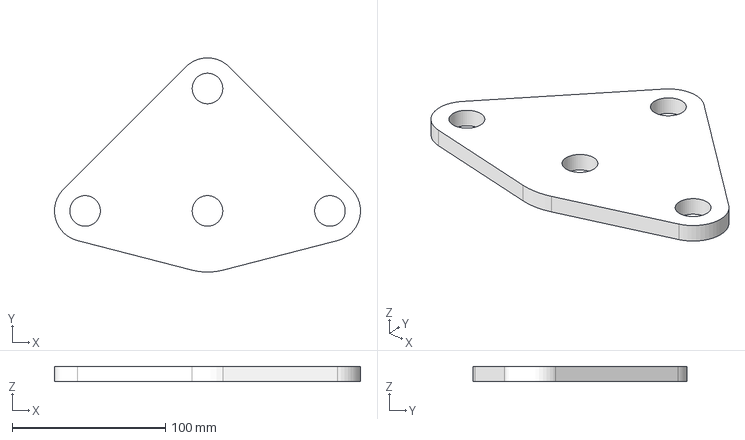
[picture p39: CAD file, 2024-03-31]
cad3d/rotary-piece-2.step
200.0 x 139.9 x 10.0 mm
