philnik/crane/cad2d/down_bracket.dxf

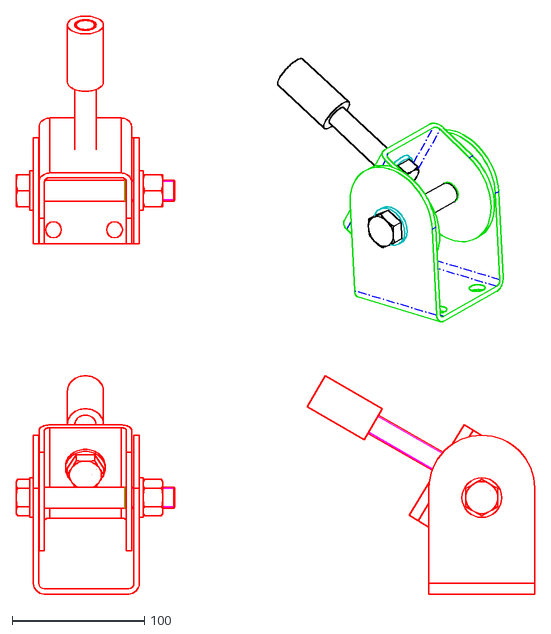
[picture p40: CAD file, 2024-03-31]
cad2d/down_bracket.dxf
392.1 x 437.2
