philnik/crane/cad3d/gearbox-small.FCStd

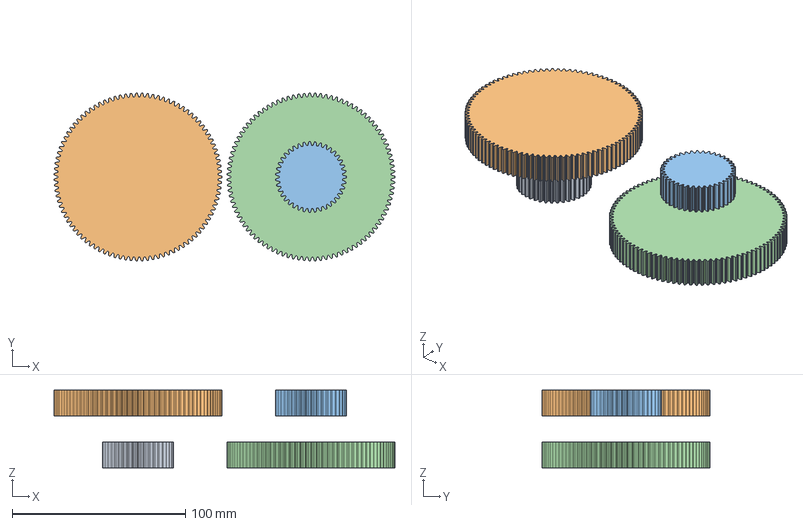
[picture p41: CAD file, 2024-03-31]
cad3d/gearbox-small.FCStd
197.0 x 97.0 x 45.0 mm
small-gear-2
