philnik/crane/cad3d/brackets.FCStd

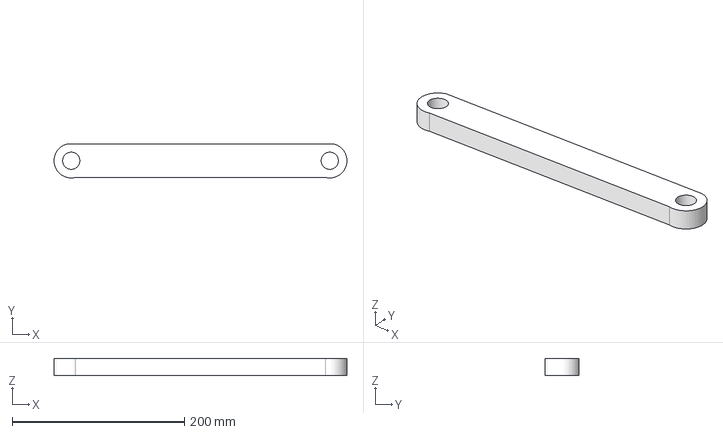
[picture p42: CAD file, 2024-03-31]
cad3d/brackets.FCStd
340.0 x 39.4 x 20.0 mm
