philnik/crane/cad3d/branch-200.step

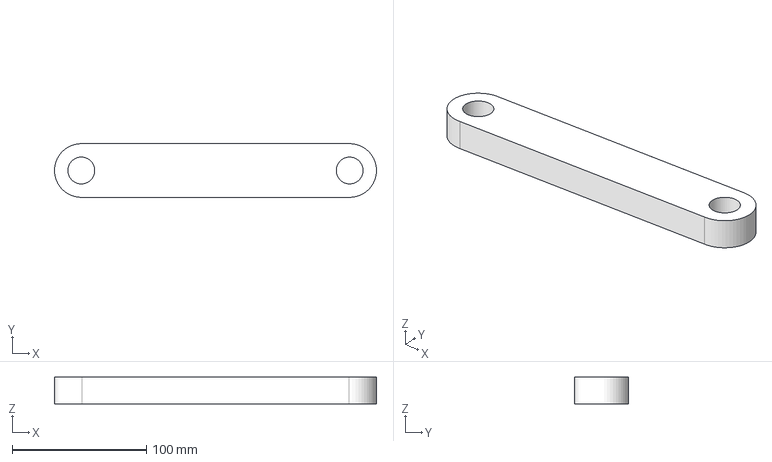
[picture p43: CAD file, 2024-03-31]
cad3d/branch-200.step
240.0 x 40.0 x 20.0 mm
