philnik/crane/cad3d/additive-wire-rop.step

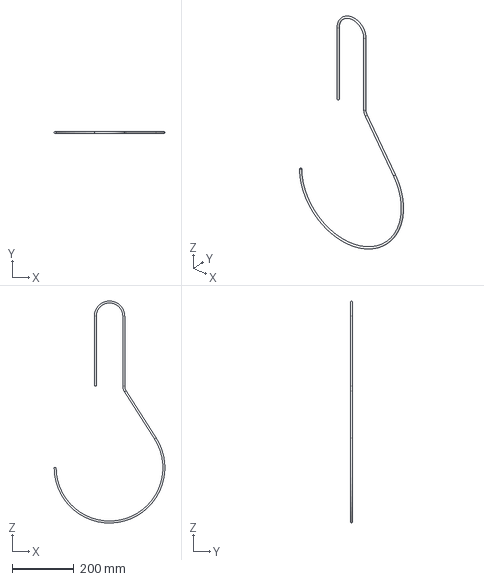
[picture p44: CAD file, 2024-03-31]
cad3d/additive-wire-rop.step
359.4 x 6.40 x 721.2 mm
