philnik/crane/cad3d/bracket_bc.stp

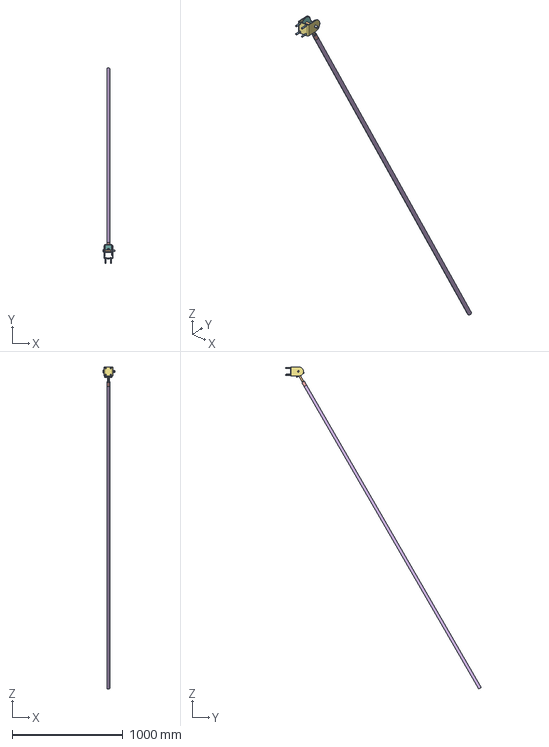
[picture p45: CAD file, 2024-03-31]
cad3d/bracket_bc.stp
110.0 x 1763.6 x 2903.7 mm
