philnik/crane/cad3d/rotary-piece-1.step

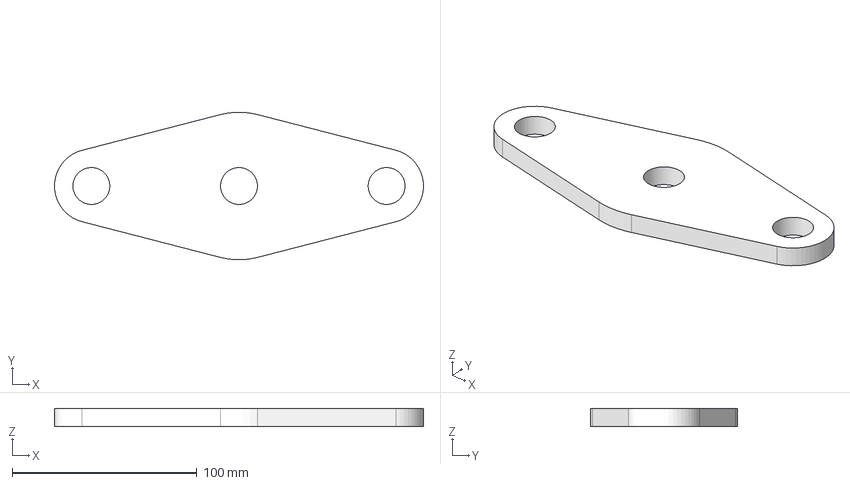
[picture p46: CAD file, 2024-03-31]
cad3d/rotary-piece-1.step
200.0 x 79.9 x 10.0 mm
