philnik/crane/cad3d/involute-panet.FCStd

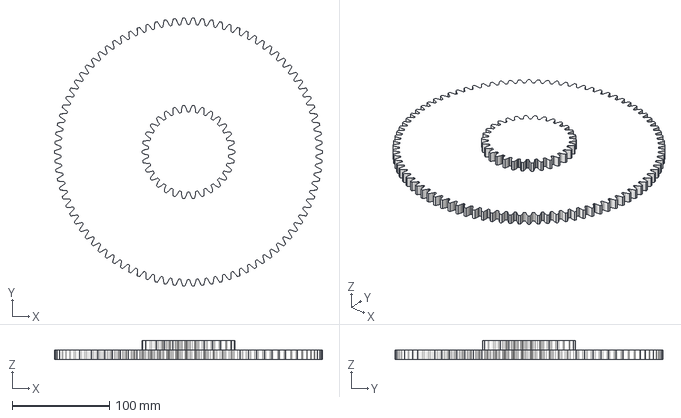
[picture p47: CAD file, 2024-03-31]
cad3d/involute-panet.FCStd
276.0 x 275.9 x 20.0 mm
