philnik/crane/cad3d/roller-detail.stp

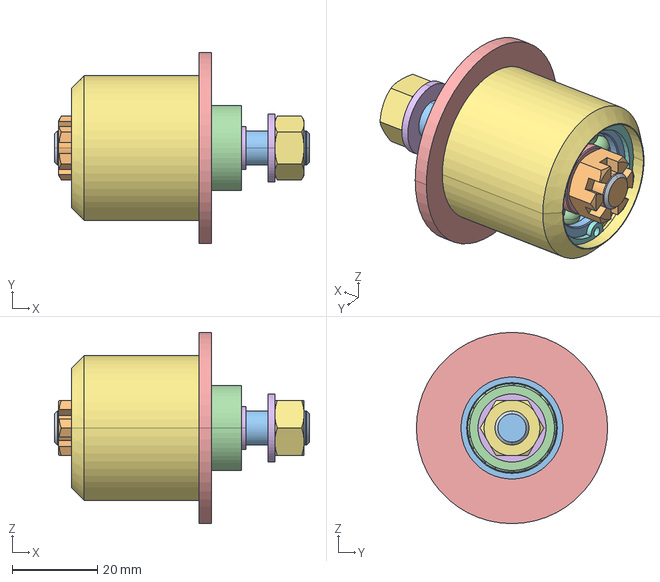
[picture p48: CAD file, 2024-03-31]
cad3d/roller-detail.stp
60.0 x 45.0 x 45.0 mm
