philnik/crane/cad2d/IPE140.dxf

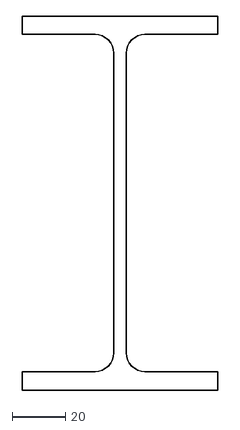
[picture p49: CAD file, 2024-03-31]
cad2d/IPE140.dxf
73.0 x 140.0
