philnik/crane/cad3d/rotary-branch-2.step

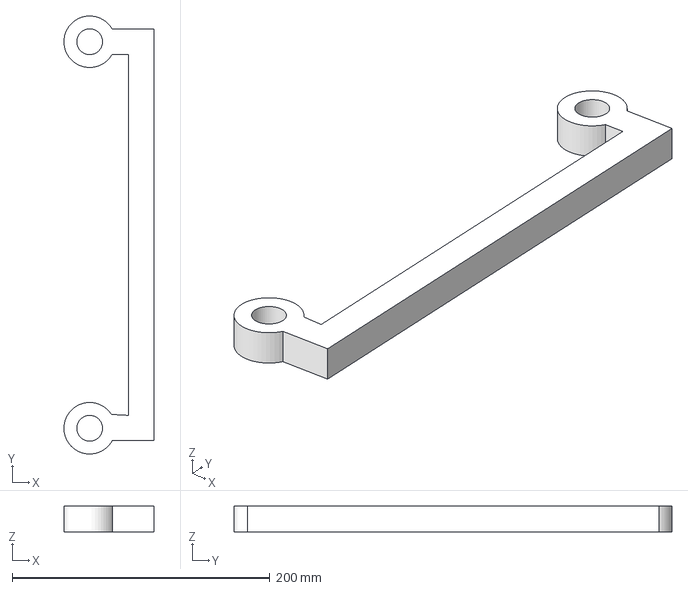
[picture p50: CAD file, 2024-03-31]
cad3d/rotary-branch-2.step
70.0 x 340.0 x 20.0 mm
