philnik/crane/cad2d/rotation-mechanism-schematics.dxf

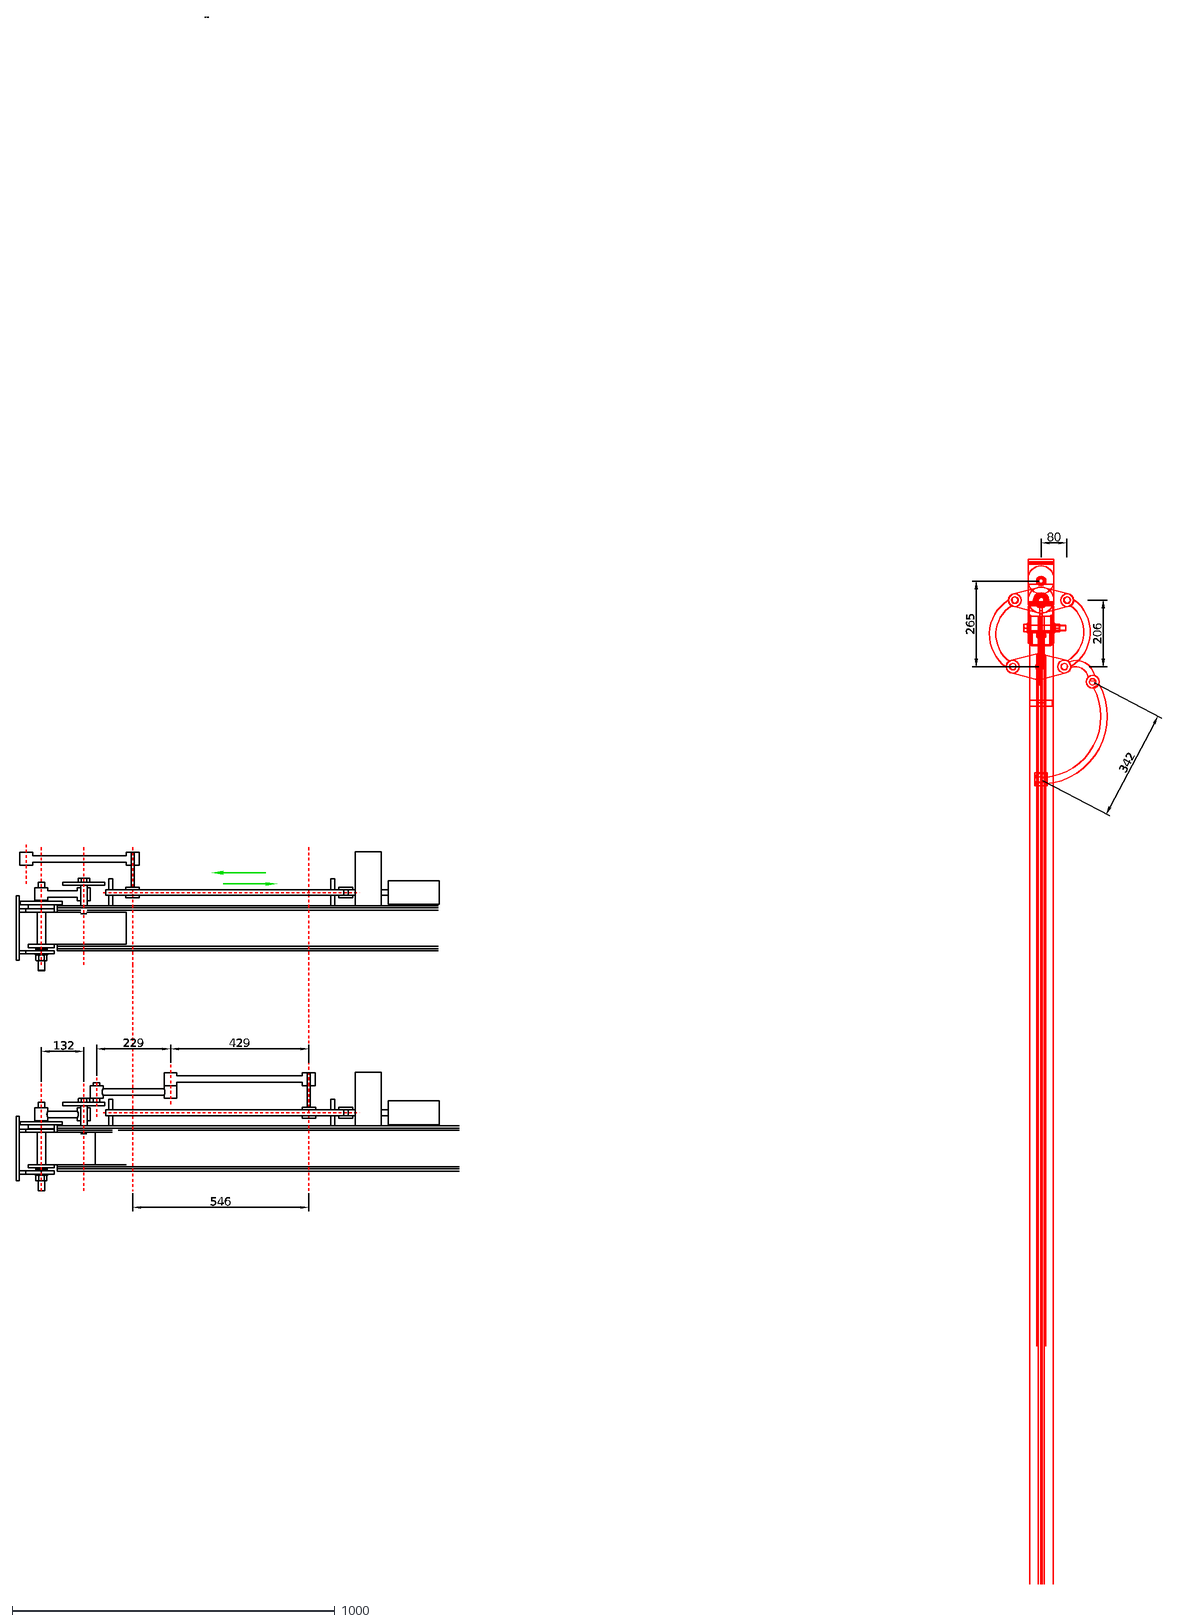
[picture p51: CAD file, 2024-03-31]
cad2d/rotation-mechanism-schematics.dxf
0
546
429
229
132
206
80
342
265
