philnik/crane/cad3d/rotary-branch-1.step

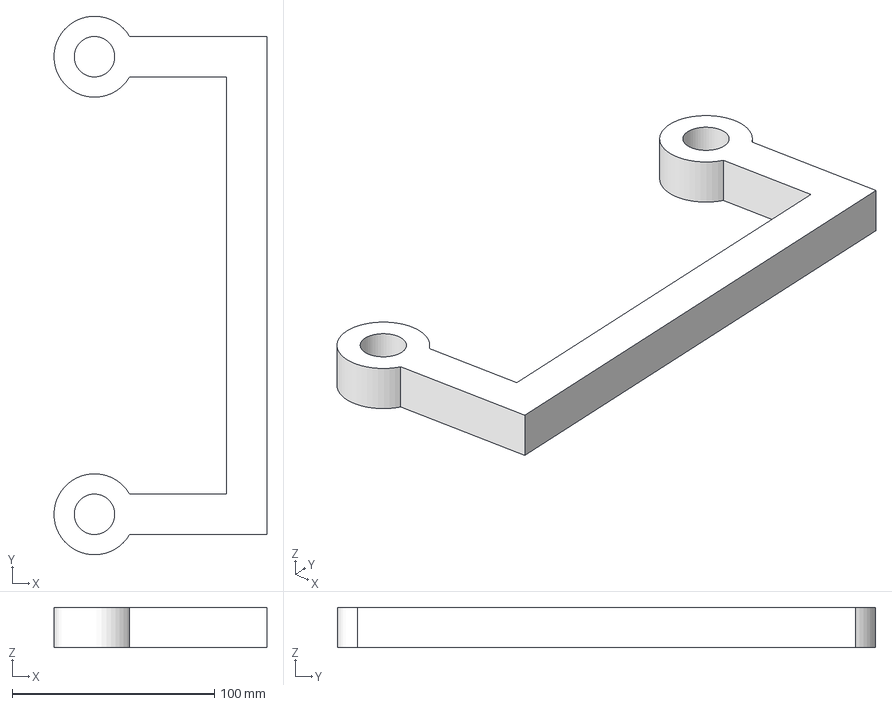
[picture p52: CAD file, 2024-03-31]
cad3d/rotary-branch-1.step
105.2 x 266.0 x 20.0 mm
