philnik/crane/cad3d/nema42-20nm.FCStd

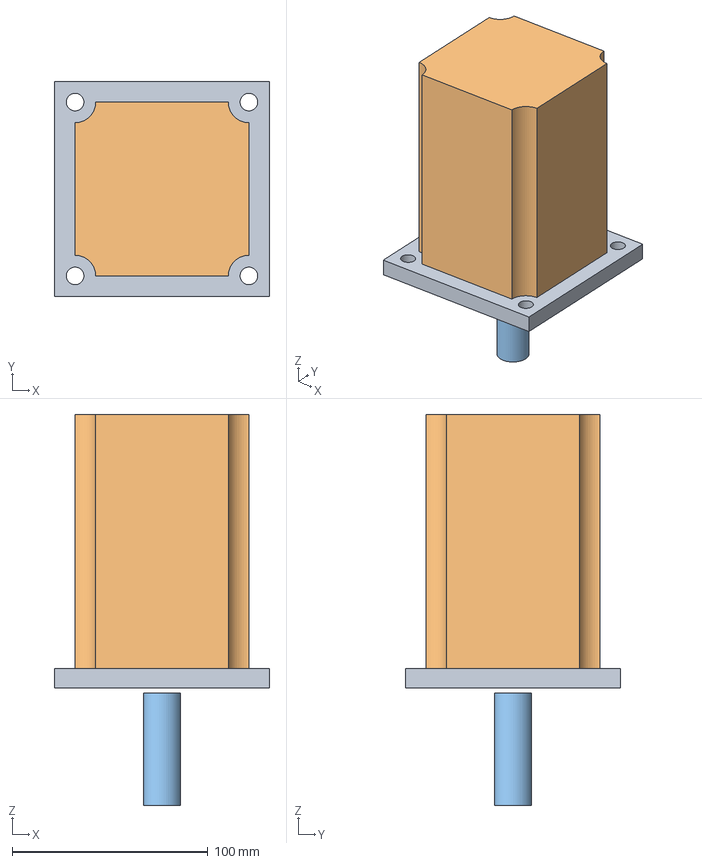
[picture p53: CAD file, 2024-03-31]
cad3d/nema42-20nm.FCStd
110.0 x 110.0 x 200.0 mm
