philnik/crane/cad2d/top_bracket.dxf

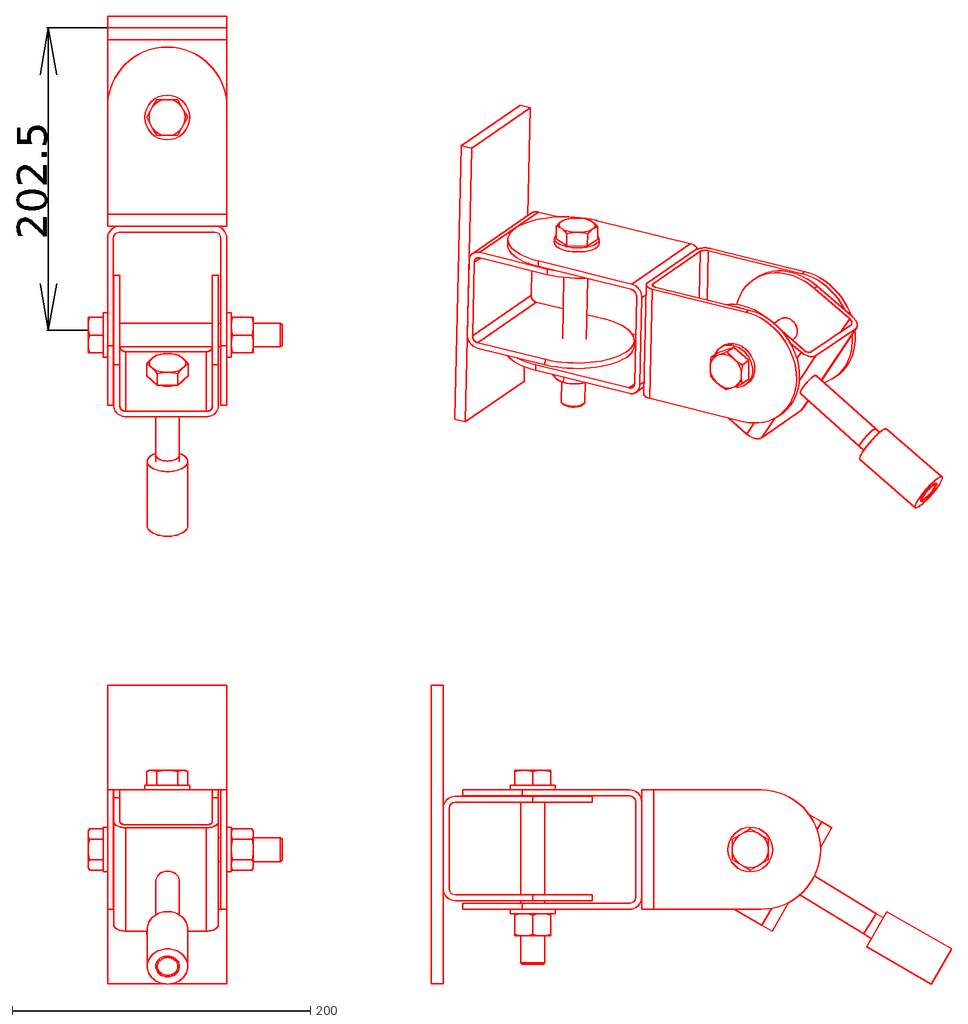
[picture p54: CAD file, 2024-03-31]
cad2d/top_bracket.dxf
202.5
