philnik/crane/cad3d/bracket1.stp

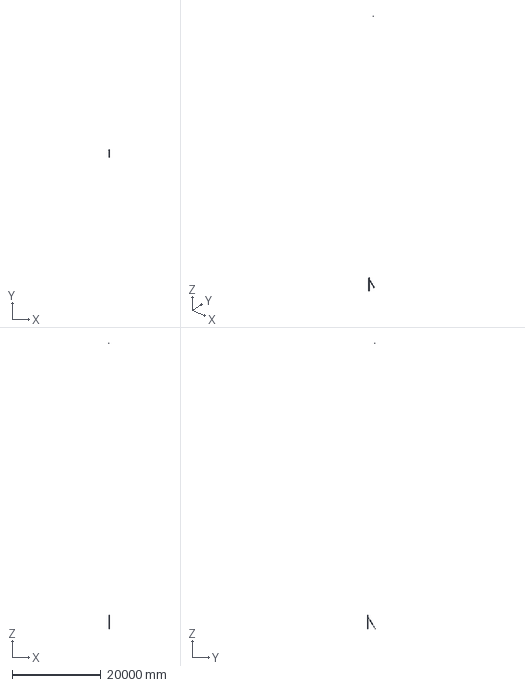
[picture p55: CAD file, 2024-03-31]
cad3d/bracket1.stp
222.2 x 1851.2 x 64449.2 mm
