philnik/crane/cad3d/large-gear-160-m2.5.FCStd

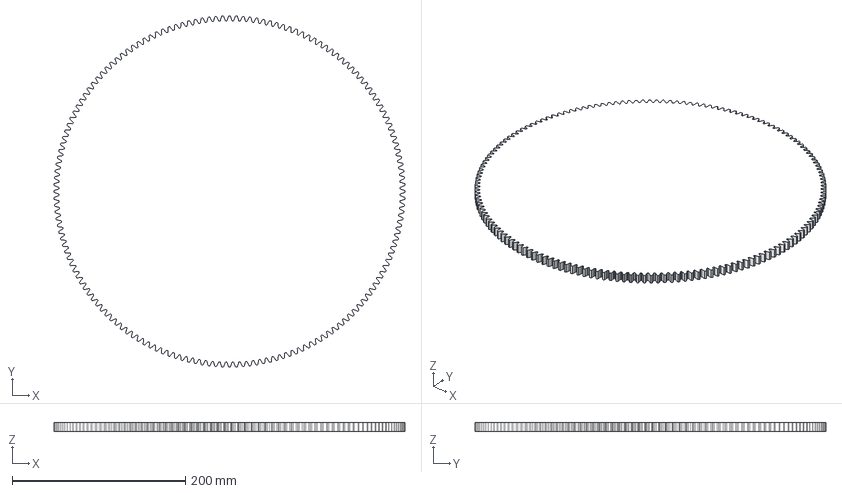
[picture p56: CAD file, 2024-03-31]
cad3d/large-gear-160-m2.5.FCStd
405.0 x 405.0 x 10.0 mm
