philnik/crane/(list of files, cad)

Other CAD files:
cad2d/Drawing1.dwg
cad3d/gear-reduction2.dwg
cad2d/bracket0.dwg
cad2d/winch.dwg
cad3d/4-linkage.FCStd
cad2d/clutch-profile.dwg
cad2d/gear-reduction3.dwg
cad2d/crane0.dwg
cad2d/motor-5,5kW-B3.dxf
cad2d/gear-reduction2.dwg
cad2d/roller-detail.dwg
cad2d/GEAR-REDUCER.dwg
cad2d/roller-wheel.dxf
cad3d/branch-300.step
cad2d/mechanism.dwg
cad3d/rotary-2.FCStd
cad3d/mechanism-sketch.FCStd
cad3d/rotary-1.FCStd
cad2d/ekkremes.dwg
cad2d/roller-wheel.dwg
cad3d/rotary-branch-1.FCStd
cad3d/rotary-branch-2.FCStd
