philnik/crane/images/rotation_mechanism.pdf

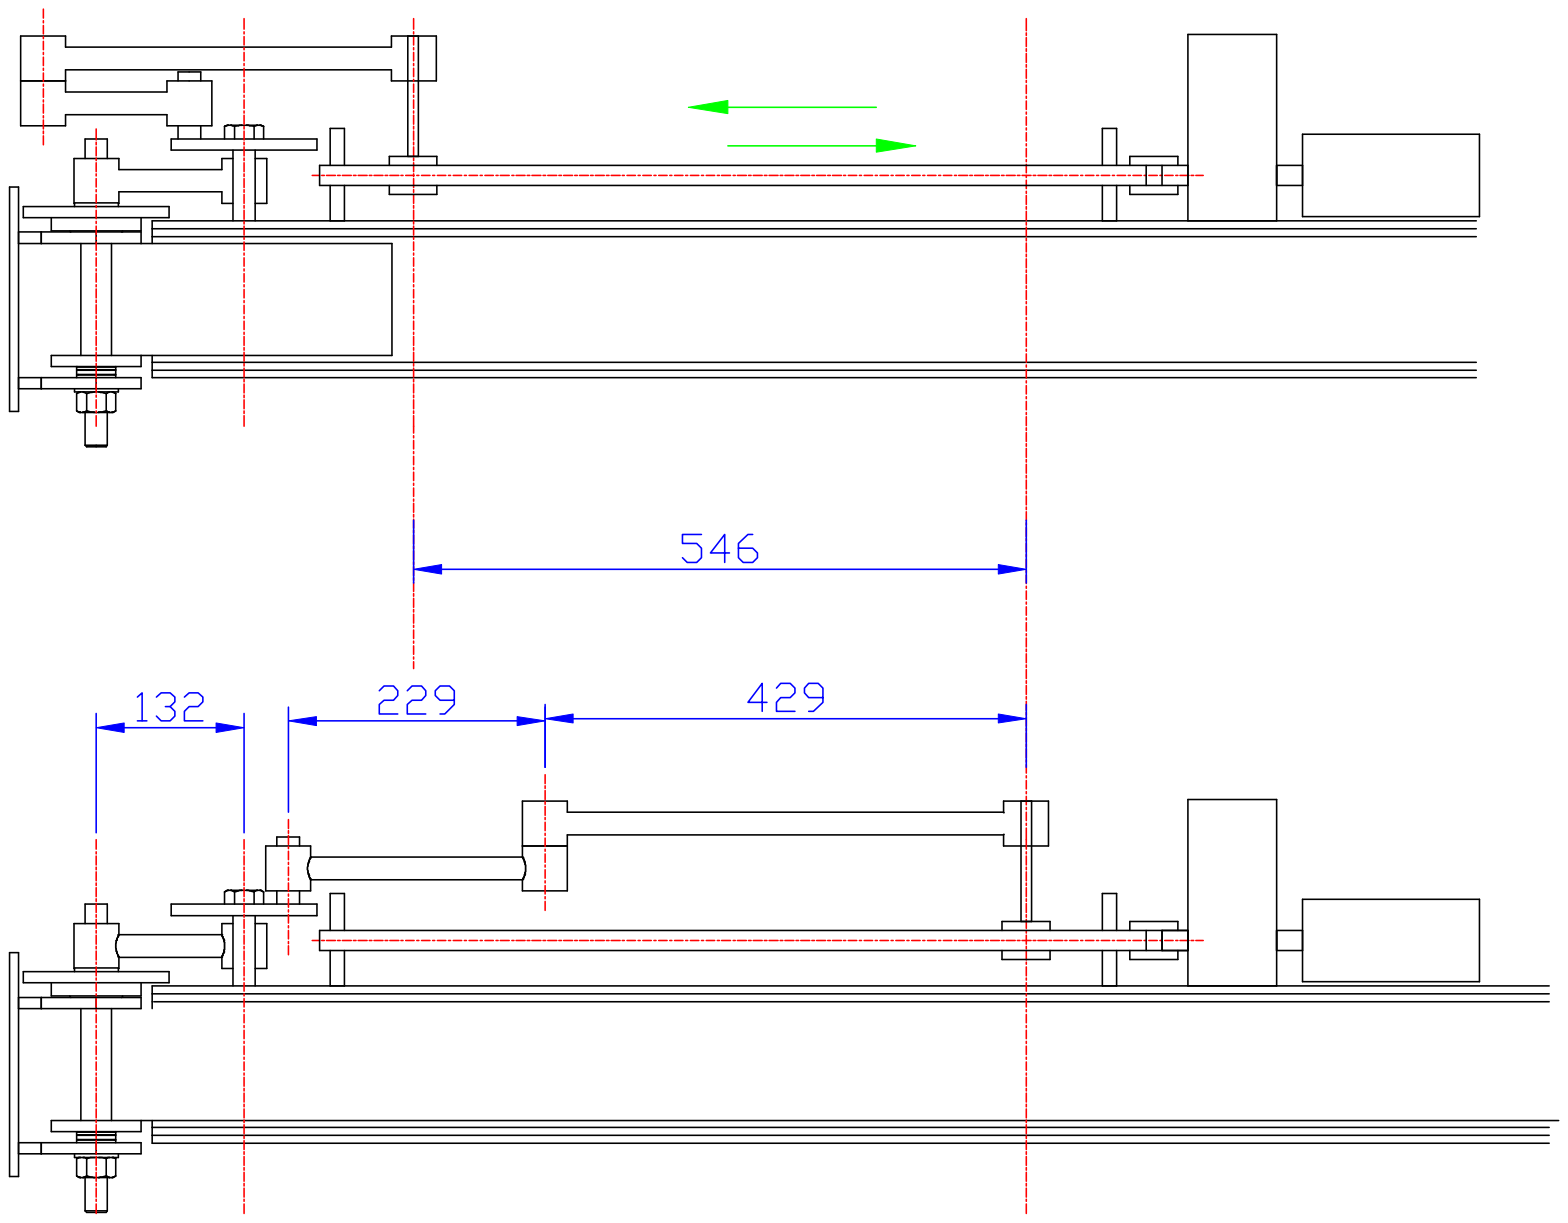
[picture p57: page 1]
