philnik/crane/pdf/GEAR-REDUCER_Model-job_36.pdf

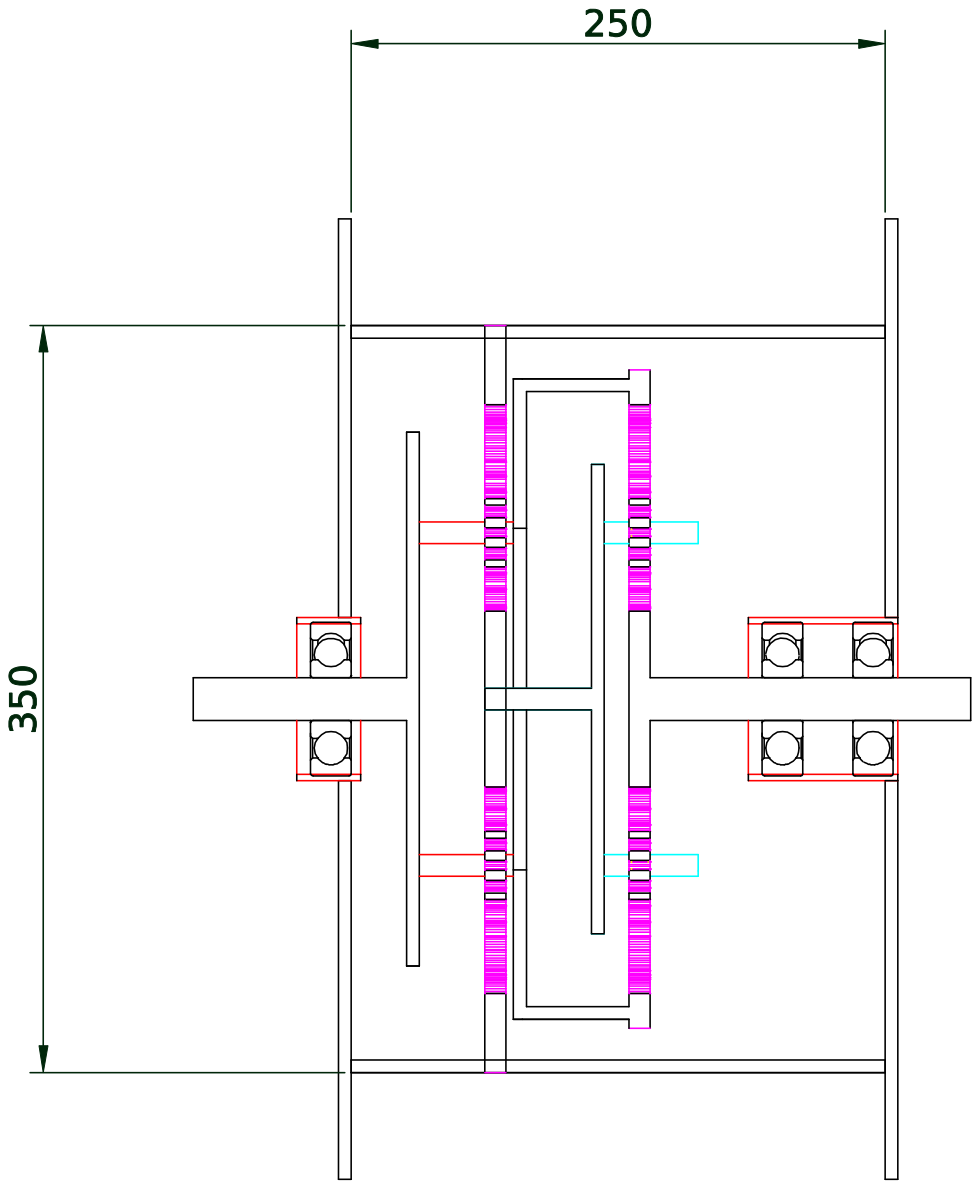
[picture p58: page 1]
