philnik/crane/pdf/roller-wheel_Model-job_25.pdf

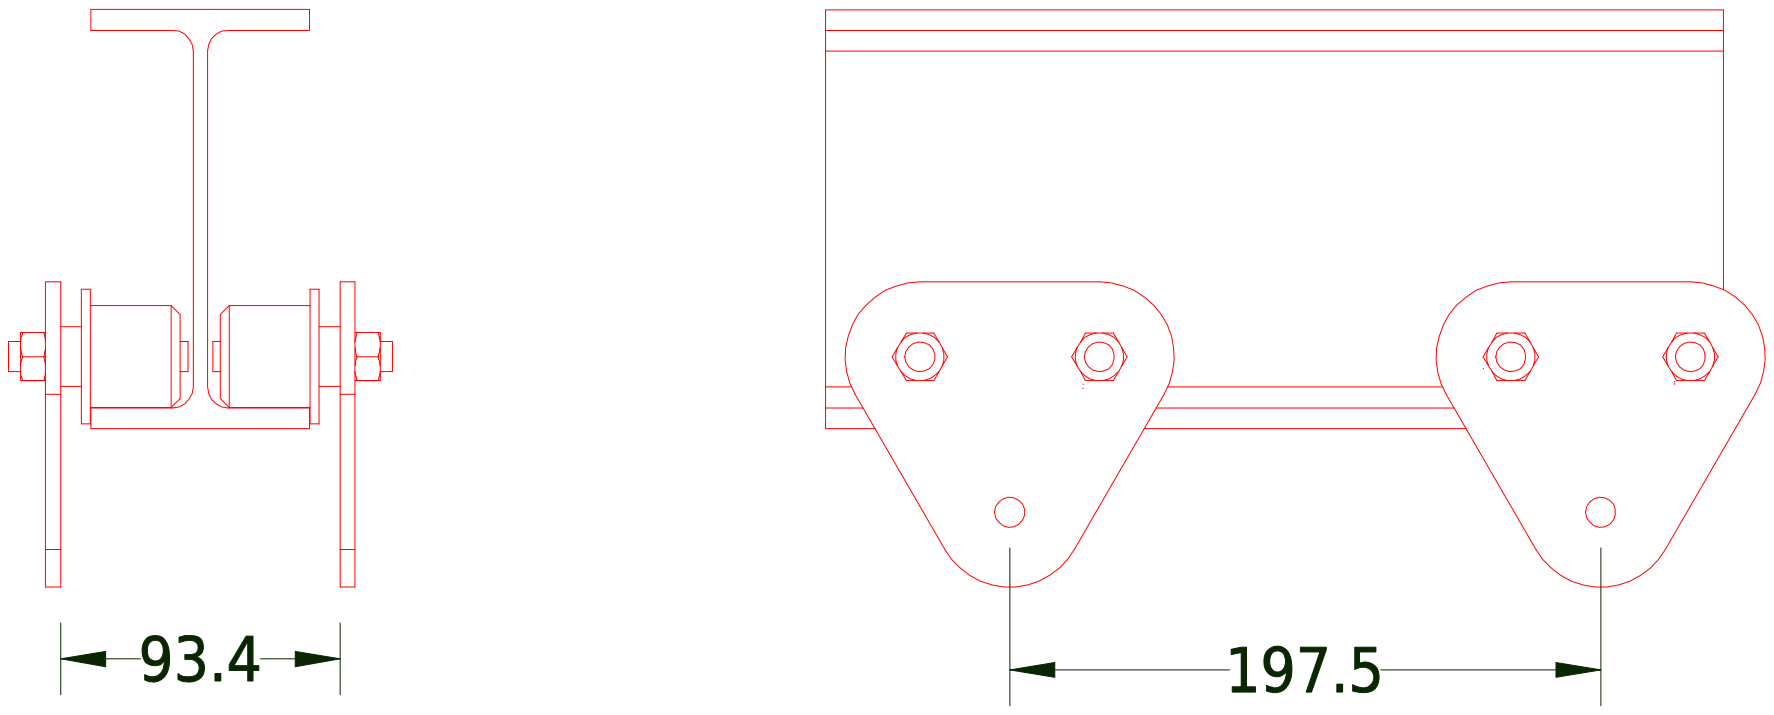
[picture p59: page 1]
